dkprasad-surati/MPPT-SOLAR-CHARGE-INVERTER/v2.2/FH70PL9K7RRAJVU.webp

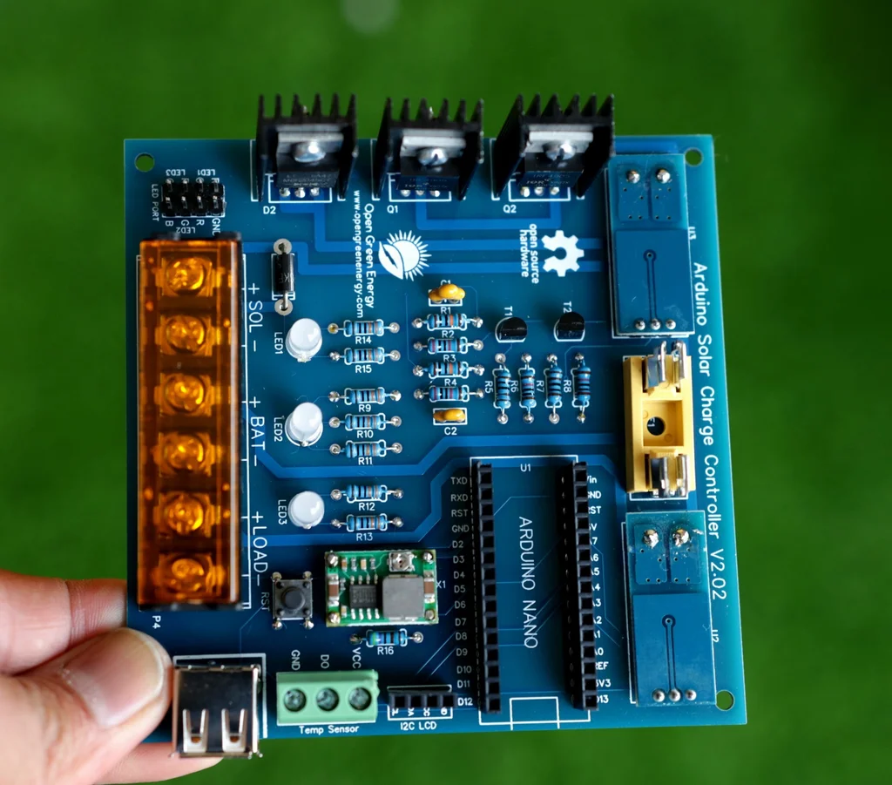
v2.2/FH70PL9K7RRAJVU.webp
