dkprasad-surati/MPPT-SOLAR-CHARGE-INVERTER/v2.2/FNMXYXHK891P6DY.webp

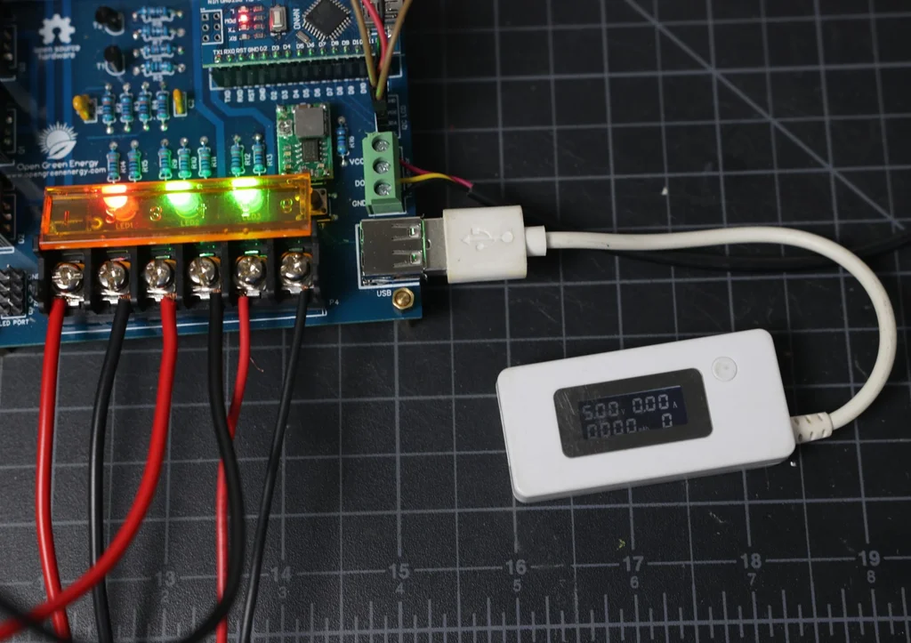
v2.2/FNMXYXHK891P6DY.webp
