dkprasad-surati/MPPT-SOLAR-CHARGE-INVERTER/README.md

# MPPT-SOLAR-CHARGE-INVERTER
SOLAR CHARGE INVERTER
