dkprasad-surati/MPPT-SOLAR-CHARGE-INVERTER/v2.2/1109151770466.png

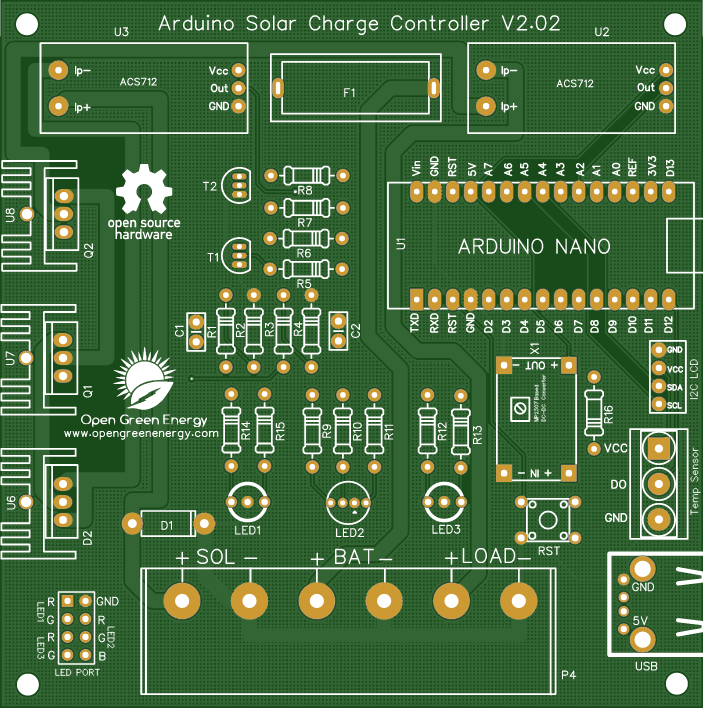
v2.2/1109151770466.png
