dkprasad-surati/MPPT-SOLAR-CHARGE-INVERTER/v2.2/F8W4K2KK891P6DU.webp

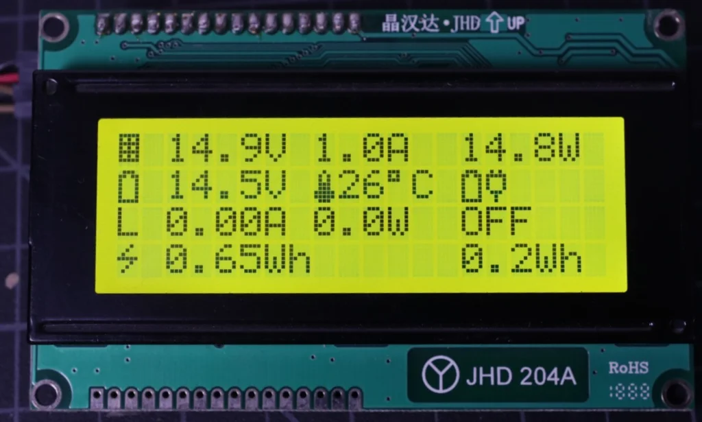
v2.2/F8W4K2KK891P6DU.webp
