dkprasad-surati/MPPT-SOLAR-CHARGE-INVERTER/v2.2/FATWU70K81UMSCC.webp

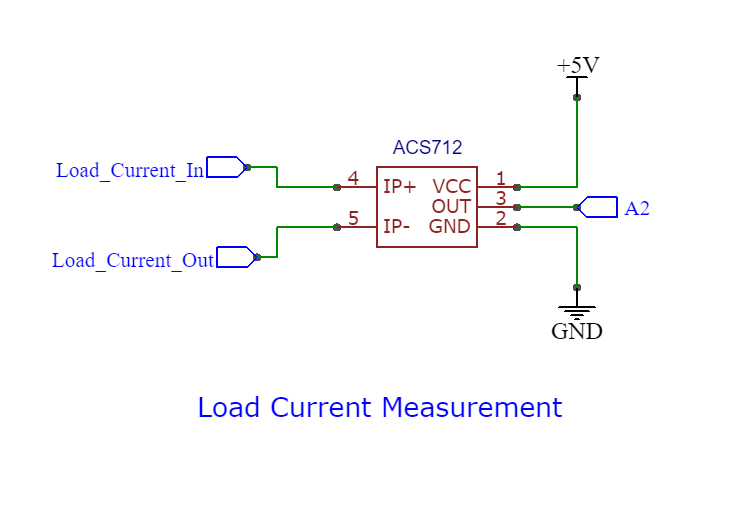
v2.2/FATWU70K81UMSCC.webp
