dkprasad-surati/MPPT-SOLAR-CHARGE-INVERTER/v2.2/FAUGJOFK7RRAL0U.webp

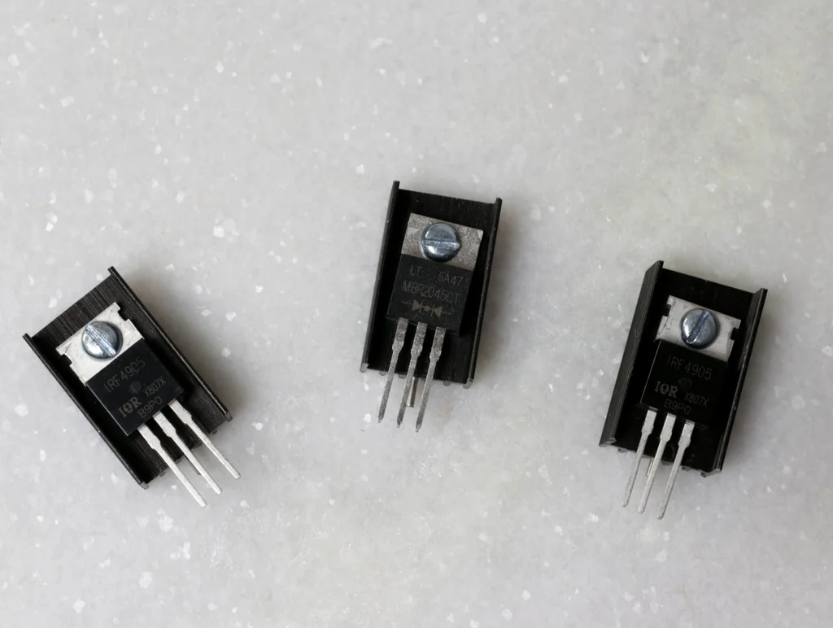
v2.2/FAUGJOFK7RRAL0U.webp
