dkprasad-surati/MPPT-SOLAR-CHARGE-INVERTER/v2.2/FCL1UGBK7RRAJVW.webp

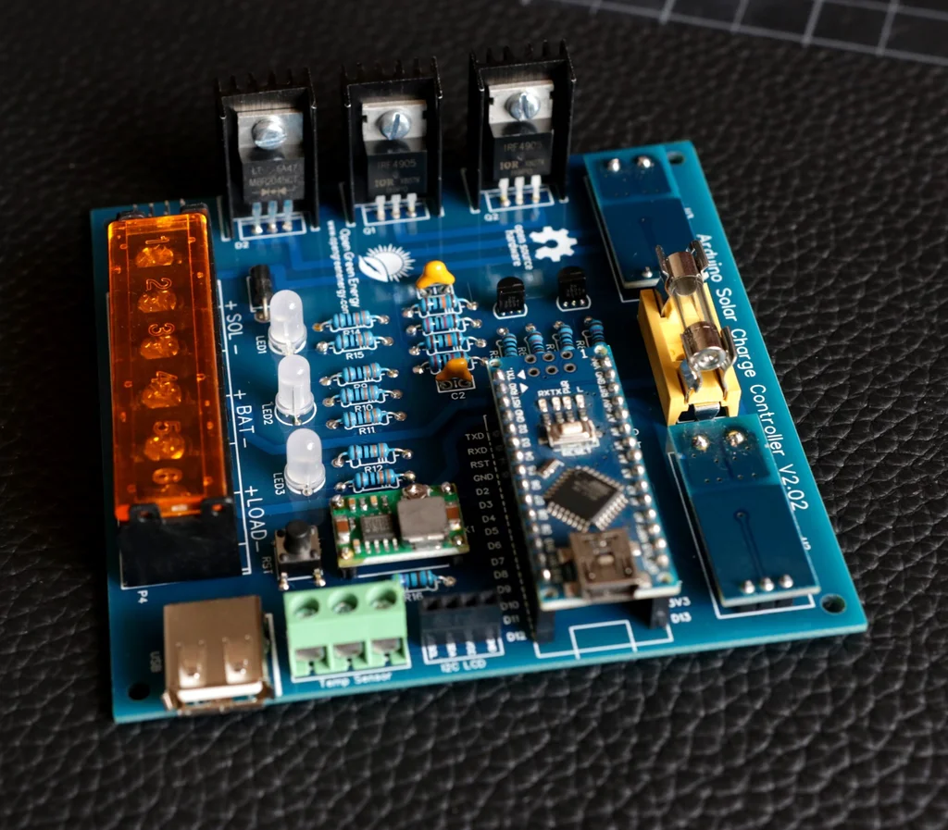
v2.2/FCL1UGBK7RRAJVW.webp
