dkprasad-surati/MPPT-SOLAR-CHARGE-INVERTER/v2.2/FDYMDO6K81UMR8P.webp

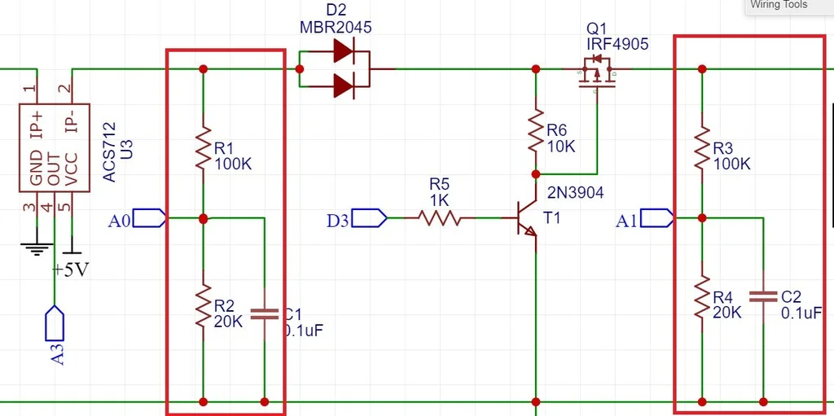
v2.2/FDYMDO6K81UMR8P.webp
