dkprasad-surati/MPPT-SOLAR-CHARGE-INVERTER/v2.2/FL9NXKZK7ZAH88T.webp

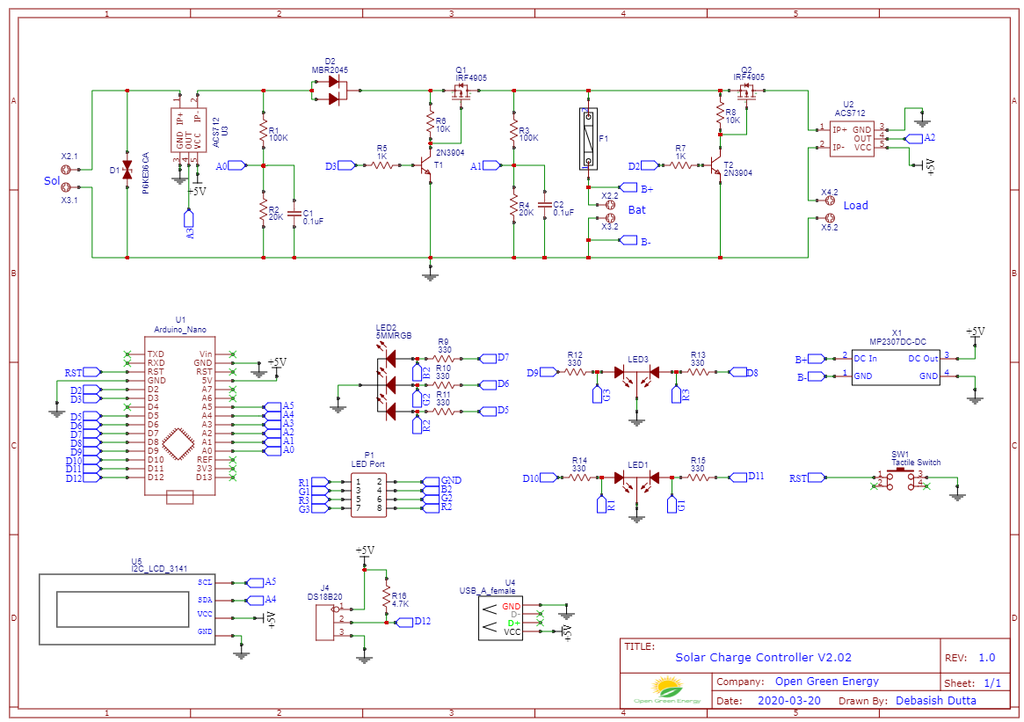
v2.2/FL9NXKZK7ZAH88T.webp
