dkprasad-surati/MPPT-SOLAR-CHARGE-INVERTER/v2.2/FLLS6NTK7VYKW1L.webp

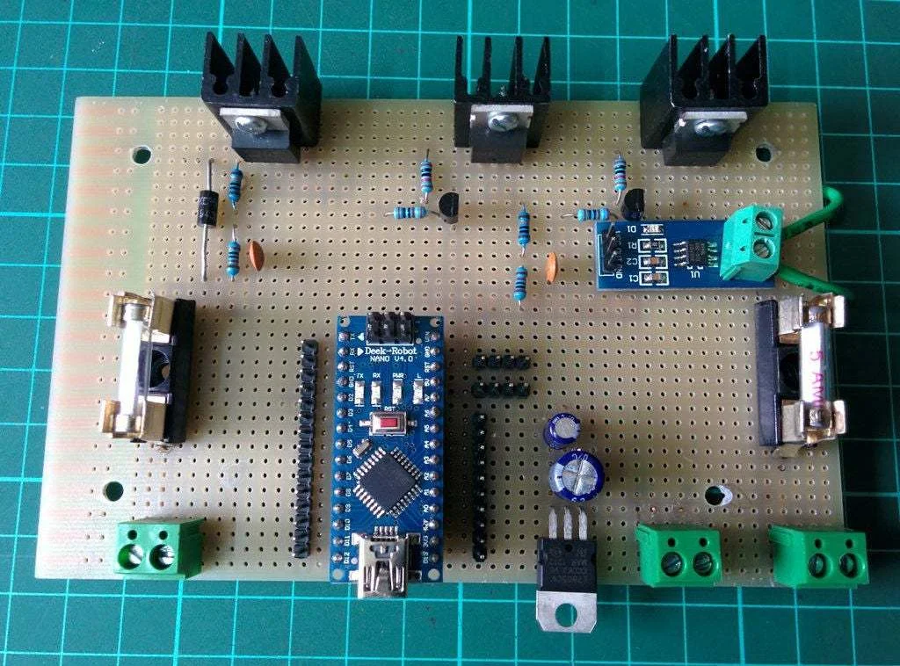
v2.2/FLLS6NTK7VYKW1L.webp
