dkprasad-surati/MPPT-SOLAR-CHARGE-INVERTER/v2.2/FLND5DZK84NFUJU.webp

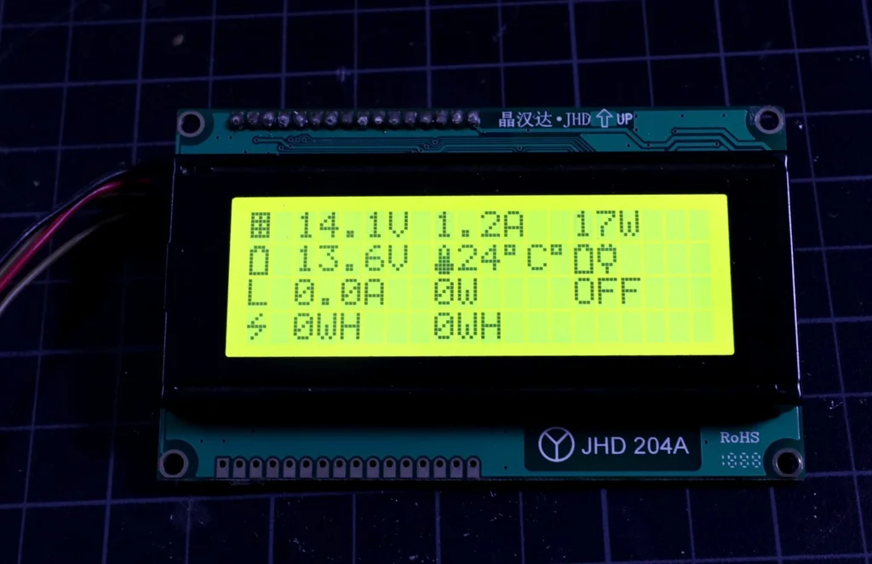
v2.2/FLND5DZK84NFUJU.webp
