dkprasad-surati/MPPT-SOLAR-CHARGE-INVERTER/v2.2/FMMB80JK7VYKW1O.webp

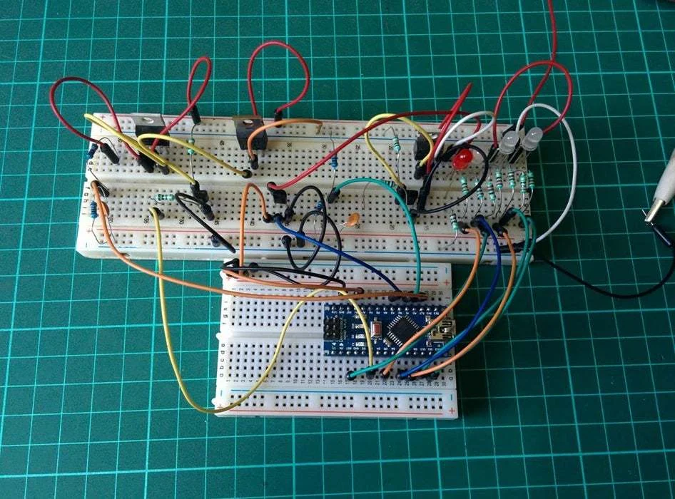
v2.2/FMMB80JK7VYKW1O.webp
