dkprasad-surati/MPPT-SOLAR-CHARGE-INVERTER/v2.2/FTX4J63K81UMX7E.webp

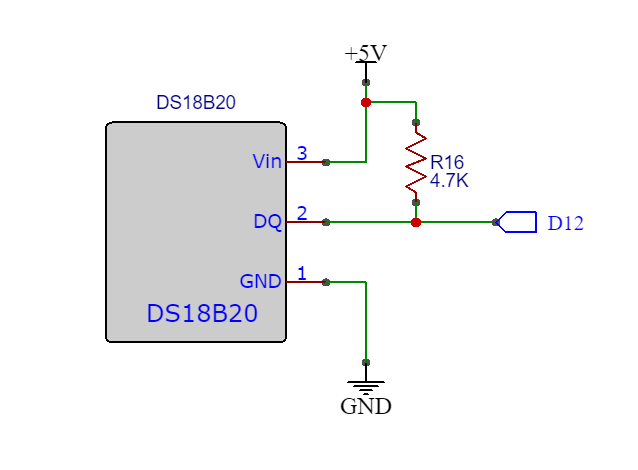
v2.2/FTX4J63K81UMX7E.webp
