dkprasad-surati/MPPT-SOLAR-CHARGE-INVERTER/v2.2/FWA54KFK7RRAJTM.webp

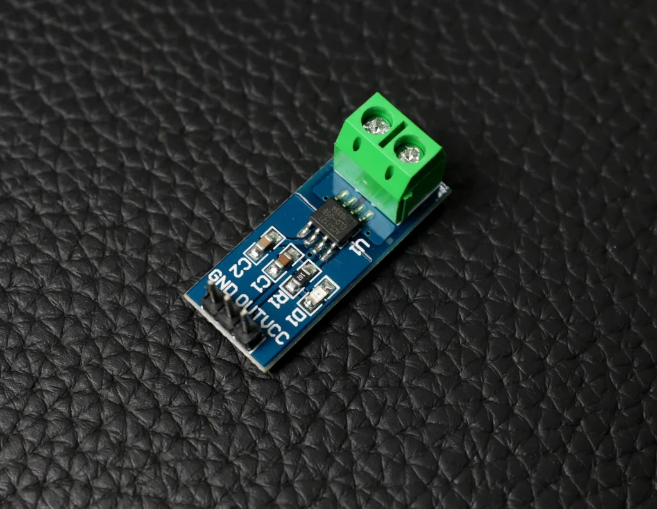
v2.2/FWA54KFK7RRAJTM.webp
