dkprasad-surati/MPPT-SOLAR-CHARGE-INVERTER/v2.2/FYMNRC1K7RRAJVV.webp

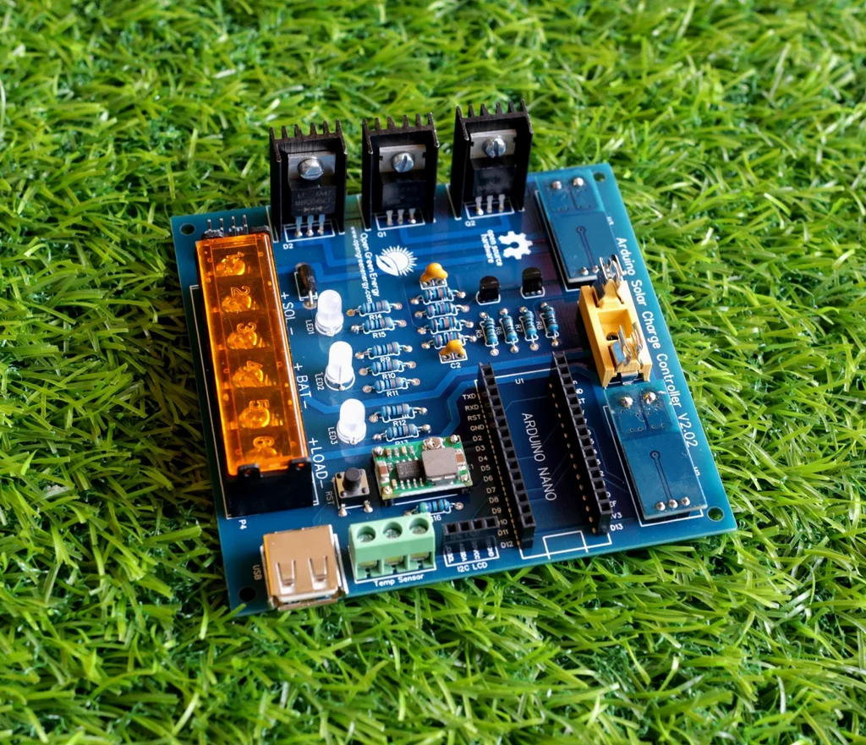
v2.2/FYMNRC1K7RRAJVV.webp
