dkprasad-surati/MPPT-SOLAR-CHARGE-INVERTER/v2.2/sdveqr.webp

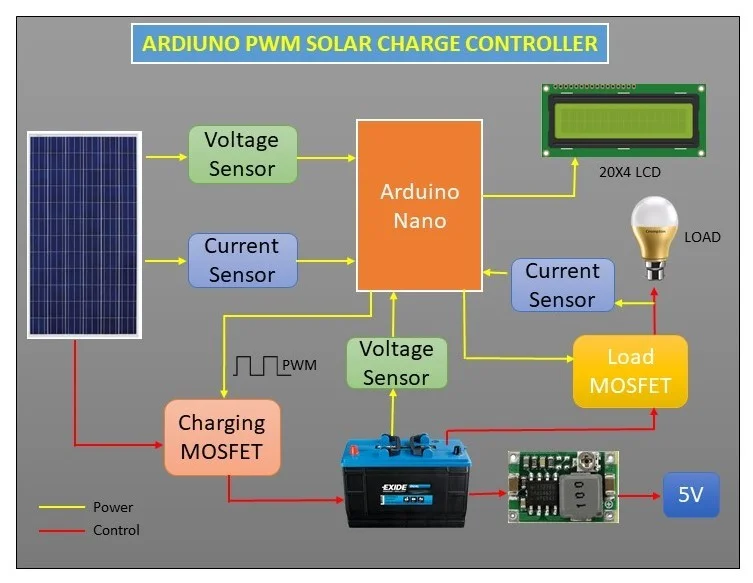
v2.2/sdveqr.webp
