dkprasad-surati/MPPT-SOLAR-CHARGE-INVERTER/v2.2/ARDUINO PWM SOLAR CHARGE CONTROLLER ( V 2.02) 25 Steps (with Pictures) - Instructables.html

Instructables instructablescircuitsProjectsContests

Enter search term

# ARDUINO PWM SOLAR CHARGE CONTROLLER ( V 2.02)

By opengreenenergy in CircuitsArduino

55,810

289

91

Featured

license

DownloadFavorite

## Introduction: ARDUINO PWM SOLAR CHARGE CONTROLLER ( V 2.02)

opengreenenergy By opengreenenergyOpen Green Energy (https://www.opengreenenergy.com/)Follow

More by the author:

DIY Mini UPS for WiFi Router V5.0

ESP8266 Weather Widget V2.0

DIY 3D-Printed Soldering Fume Extractor

About: I am a DIY hobbyist by passion and Power Engineer by profession. Most of my works are related to Solar Energy and Arduino. Apart from Electronics I love 3D printing, Woodworking and to make crafts from used … More About opengreenenergy »

(https://www.banggood.in/custlink/v3G3M9ZGNf) (https://www.banggood.in/custlink/DGGKUI8Ksj)If you are planning to install an off-grid solar system with a battery bank, you’ll need a Solar Charge Controller. It is a device that is placed between the Solar Panel and the Battery Bank to control the amount of electric energy produced by Solar panels going into the batteries. The main function is to make sure that the battery is properly charged and protected from overcharging.
As the input voltage from the solar panel rises, the charge controller regulates the charge to the batteries preventing any overcharging and disconnect the load when the battery is discharged.

You can go through my Solar projects on my website: www.opengreenenergy.com and YouTube Channel: Open Green Energy (http://www.youtube.com/c/opengreenenergy)

Types of solar charge controllers

There are currently two types of charge controllers commonly used in PV power systems :

1. Pulse Width Modulation (PWM) controller

2. Maximum Power Point Tracking (MPPT) controller

In this Instructable, I will explain to you about the PWM Solar Charge Controller. I have posted few articles on PWM charge controllers earlier too. The earlier version of my solar charge controllers are quite popular on the internet and useful for people all around the globe.

By considering the comments and questions from my earlier versions, I have modified my existing V2.0 PWM Charge Controller (https://www.instructables.com/id/ARDUINO-SOLAR-CHARGE-CONTROLLER-Version-20/) to make the new version 2.02.

The following are the changes in V2.02 w.r.t V2.0:

1. The low efficient linear voltage regulator is replaced by buck converter MP2307 for 5V power supply.

2. One additional current sensor to monitor current coming from the solar panel.

3. MOSFET-IRF9540 is replaced by IRF4905 for better performance.

4. Onboard LM35 temp-sensor is replaced by a DS18B20 probe for accurate battery temperature monitoring.

5. USB port for charging smart devices.

6. Use of single fuse instead of two

7. One additional LED to indicate Solar Power Status.

8.Implementation of 3 stages charging algorithm.

9.Implementation of PID controller in the charging algorithm

10. Made a custom PCB for the project

Specification

1.Charge controller as well as energy meter

2. Automatic Battery Voltage Selection (6V/12V)

3.PWM charging algorithm with auto charge setpoint according to the battery voltage

4.LED indication for the state of charge and load status

5. 20x4 character LCD display for displaying voltages, current, power, energy, and temperature.

6.Lightning protection

7.Reverse current flow protection

8.Short Circuit and Overload protection

9. Temperature Compensation for Charging

10. USB port for Charging Gadgets

Add TipAsk QuestionCommentDownload

## Supplies

You can order the PCB V2.02 from PCBWay (https://www.pcbway.com/project/shareproject/ARDUINO_PWM_SOLAR_CHARGE_CONTROLLER___V_2_02_.html)

(https://www.pcbway.com/project/shareproject/ARDUINO_PWM_SOLAR_CHARGE_CONTROLLER___V_2_02_.html)

1. Arduino Nano (Amazon (https://amzn.to/3a8rkF9) / Banggood (https://www.banggood.in/custlink/mmGvMI9mlo))

2.P-MOSFET - IRF4905 ( Amazon (https://amzn.to/2wpN9kR) / Banggood (https://www.banggood.in/custlink/DGD3kSZmas) )

3.Power diode -MBR2045( Amazon (https://amzn.to/2IZZf73) / Aliexpress (https://www.aliexpress.com/item/33037450545.html))

4.Buck Converter-MP2307( Amazon (https://amzn.to/2xP1IyM) / Banggood (https://www.banggood.in/custlink/GmmDzI8Dgh))

5.Temperature Sensor - DS18B20 ( Amazon (https://amzn.to/398hjX8) / Banggood (https://www.banggood.in/custlink/DDv329iKBV))

6.Current Sensor - ACS712 ( Amazon (https://amzn.to/2UpupKb) / Banggood (https://www.banggood.in/custlink/mv3vz8imgO))

7.TVS diode- P6KE36CA ( Amazon (https://amzn.to/2xaVV6x) / Aliexpress (https://www.aliexpress.com/item/32409284088.html))

8.Transistors - 2N3904 (Amazon (https://amzn.to/2J3bzTW) / Banggood (https://www.banggood.in/custlink/mm3Gk89vQH))

9.Resistors ( 100k x 2, 20k x 2,10k x 2,1k x 2, 330ohm x 7) ( Amazon (https://amzn.to/2U4fYfJ) / Banggood (https://www.banggood.in/custlink/DGGKUI8Ksj) )

10.Ceramic Capacitors (0.1uF x 2) ( Amazon (https://amzn.to/2U7knyK) / Banggood (https://www.banggood.in/custlink/v3G3M9ZGNf) )

11. 20x4 I2C LCD ( Amazon (https://amzn.to/33vVeR6) / Banggood (https://www.banggood.in/custlink/vGK3MiSRRD))

12.RGB LED ( Amazon (https://amzn.to/2wqBdiK) / Banggood (https://www.banggood.in/custlink/3K33MI8ddE))

13.Bi-Color LED ( Amazon (https://amzn.to/33zrgM0) )

15.Jumper Wires/Wires ( Amazon (https://amzn.to/390KnzL) / Banggood (https://www.banggood.in/custlink/3KDDz8IdEC))

16.Header Pins ( Amazon (https://amzn.to/2WtT2IA) / Banggood (https://www.banggood.in/custlink/GvK3zIIEyw) )

17.Heat Sinks ( Amazon (https://amzn.to/3b8Kaw3) / Aliexpress (https://www.aliexpress.com/item/32923541255.html?spm=a2g0s.9042311.0.0.27424c4d8IPTtM))

18.Fuse Holder and fuses ( Amazon (https://amzn.to/3a7hYJV) )

19.Push Button ( Amazon (https://amzn.to/2x7tdU6) / Banggood (https://www.banggood.in/custlink/mKmK29SYFb) )

22.Screw terminals 1x6 pin ( Aliexpress (https://www.aliexpress.com/item/32963802060.html?spm=a2g0s.9042311.0.0.27424c4d862aP3))

23.PCB Standoffs ( Banggood (https://www.banggood.in/custlink/KmDK2Z8hjp) )

24. USB Socket ( Amazon (https://amzn.to/2J3Is33) / Banggood (https://www.banggood.in/custlink/3vmmkiiYj0) )

Tools :

1.Soldering Iron ( Amazon (https://amzn.to/3a7vzRj) )

2. Desoldering Pump ( Amazon (https://amzn.to/392ubhp) )

2.Wire Cutter and Stripper ( Amazon (https://amzn.to/391y2vr) )

3.Screw Driver ( Amazon (https://amzn.to/2we3tp1) )

Add TipAsk QuestionCommentDownload

## Step 1: Working Principle of a PWM Charge Controller

PWM stands for Pulse Width Modulation, which stands for the method it uses to regulate charge. Its function is to pull down the voltage of the solar panel to near that of the battery to ensure that the battery is properly charged. In other words, they lock the solar panel voltage to the battery voltage by dragging the Solar panel Vmp down to the battery system voltage with no change in the current.

It uses an electronics switch ( MOSFET ) to connect and disconnect the solar panel with the battery. By switching the MOSFET at high frequency with various pulse widths, a constant voltage can be maintained. The PWM controller self-adjusts by varying the widths (lengths) and frequency of the pulses sent to the battery.

When the width is at 100%, the MOSFET is at full ON, allowing the solar panel to bulk charge the battery. When the width is at 0% the transistor is OFF open circuiting the Solar panel preventing any current from flowing to the battery when the battery is fully charged.

Add TipAsk QuestionCommentDownload

## Step 2: How the Circuit Works ?

The heart of the charge controller is an Arduino Nano board. The Arduino senses the solar panel and battery voltages by using two voltage divider circuits. According to these voltage levels, it decides how to charge the battery and control the load.

Note : In the above picture, there is typographical error in power and control signal. The redline is for power and yellow line is for control signal.

The whole schematic is divided into the following circuits:

1. Power Distribution Circuit:

The power from the battery ( B+ & B- ) is step down to 5V by the X1 ( MP2307) buck converter. The output from the buck converter is distributed to

1. Arduino Board

2. LEDs for indication

3. LCD display

4. USB port to charge gadgets.

2. Input Sensors:

The solar panel and battery voltages are sensed by using two voltage divider circuits consisting of resistors R1-R2 & R3- R4. C1 and C2 are filter capacitors to filter out the unwanted noise signals. The output from the voltage dividers is connected to Arduino analog pins A0 and A1 respectively.

The solar panel and load currents are sensed by using two ACS712 modules. The output from the current sensors is connected to Arduino analog pin A3 and A2 respectively.

The battery temperature is measured by using a DS18B20 temperature sensor. R16 (4.7K ) is a pull-up resistor. The output of the temperature sensor is connected to Arduino Digital pin D12.

3. Control Circuits:

The control circuits are basically formed by two p-MOSFETs Q1 and Q2. The MOSFET Q1 is used to send the charging pulse to the battery and MOSFET Q2 is used to drive the load. Two MOSFET driver circuits are consist of two transistors T1 and T2 with pull-up resistors R6 and R8. The base current of the transistors is controlled by resistors R5 and R7.

4. Protections Circuits:

The input overvoltage from the solar panel side is protected by using a TVS diode D1. The reverse current from the battery to the solar panel is protected by a Schottky diode D2. The overcurrent is protected by a fuse F1.

5. LED Indication:

LED1, LED2, and LED3 are used to indicate solar, battery and load status respectively. Resistors R9 to R15 are current limiting resistors.

7. LCD Display:

An I2C LCD display is used to display various parameters.

8. USB Charging:

The USB socket is hooked up to 5V output from the Buck Converter.

9. System Reset:

SW1 is a push button to reset the Arduino.

You can download the schematic in PDF format attached below.

### Attachments

- download {{ file.name }} Schematic_Arduino Solar Charge Controller V2.0_Sheet_1_20200320104815.pdf (https://content.instructables.com/ORIG/FBF/G1O4/K7ZAH87I/FBFG1O4K7ZAH87I.pdf)
  Download (https://content.instructables.com/ORIG/FBF/G1O4/K7ZAH87I/FBFG1O4K7ZAH87I.pdf)

Add TipAsk QuestionCommentDownload

## Step 3: Main Functions of Solar Charge Controller

The charge controller is designed by taking care of the following points.

1. Prevent Battery Overcharge: To limit the energy supplied to the battery by the solar panel when the battery becomes fully charged. This is implemented in charge_cycle() of my code.

2. Prevent Battery Over-discharge: To disconnect the battery from electrical loads when the battery reaches a low state of charge. This is implemented in load_control() of my code.

3. Provide Load Control Functions: To automatically connect and disconnect an electrical load at a specified time. The load will ON when the sunset and OFF when sunrise. This is implemented in load_control() of my code. 4.Monitoring Power and Energy: To monitor the load power and energy and display it.

5. Protect from abnormal Condition: To protect the circuit from the different abnormal situations like lightning, overvoltage, overcurrent, and short circuit, etc.

6.Indicating and Displaying: To indicate and display the various parameters

7.Serial Communication: To print various parameters in the serial monitor

8. USB Charging: To charge smart devices

Add TipAsk QuestionCommentDownload

## Step 4: Voltage Measurement

The voltage sensors are used to sense the voltage of solar panel and battery. It is implemented by using two voltage divider circuits. It consists of two resistors R1=100k and R2=20k for sensing the solar panel voltage and similarly R3=100k and R4=20k for battery voltage. The output from the R1and R2 is connected to Arduino analog pin A0 and output from the R3 and R4 is connected to Arduino analog pin A1.

Voltage Measurement :
Arduino’s analog inputs can be used to measure DC voltage between 0 and 5V (when using the standard 5V analog reference voltage) and this range can be increased by using a voltage divider network. The voltage divider steps down the voltage being measured within the range of the Arduino analog inputs.

For a voltage divider circuit Vout = R2/(R1+R2) x Vin

Vin = (R1+R2)/R2 x Vout

The analogRead() function reads the voltage and converts it to a number between 0 and 1023

Calibration :
We’re going to read output value with one of the analog inputs of Arduino and its analogRead() function. That function outputs a value between 0 and 1023 that is 0.00488V for each increment (As 5/1024 = 0.00488V)

Vin = Vout*(R1+R2)/R2 ; R1=100k and R2=20k

Vin= ADC count*0.00488*(120/20) Volt // Highlighted part is Scale factor

Note: This leads us to believe that a reading of 1023 corresponds to an input voltage of exactly 5.0 volts. In practical you may not get 5V always from the Arduino pin 5V. So during calibration first measure the voltage between the 5v and GND pins of Arduino by using a multimeter, and use scale factor by using the below formula:

Scale factor = measured voltage/1024

Add TipAsk QuestionCommentDownload

## Step 5: Current Measurement

For current measurement, I used a Hall Effect current sensor ACS 712 -5A variant. There are three variants of ACS712 Sensor based on the range of its current sensing. The ACS712 sensor reads the current value and converts it into a relevant voltage value, The value that links the two measurements is Sensitivity. The output sensitivity for all variant are as follows:

ACS712 Model - > Current Range- > Sensitivity

ACS712 ELC-05 - > +/- 5A - > 185 mV/A

ACS712 ELC-20 - > +/- 20A - > 100 mV/A

ACS712 ELC-30 - > +/- 30A - > 66 mV/A

In this project, I have used the 5A variant, for which sensitivity is 185mV/A and the middle sensing voltage is 2.5V when no current.

Calibration:

analog read value = analogRead(Pin);

Value = (5/1024)*analog read value // If you are not getting 5V from Arduino 5V pin then,

Current in amp = (Value – offsetVoltage) / sensitivity

But as per data sheets offset voltage is 2.5V and sensitivity is 185mV/A

Current in amp = (Value-2.5)/0.185

Add TipAsk QuestionCommentDownload

## Step 6: Temperature Measurement

Why Temperature monitoring is Required?

The battery’s chemical reactions change with temperature. As the battery gets warmer, the gassing increases. As the battery gets colder, it becomes more resistant to charging. Depending on how much the battery temperature varies, it is important to adjust the charging for temperature changes. So it is important to adjust charging to account for the temperature effects. The temperature sensor will measure the battery temperature, and the Solar Charge Controller uses this input to adjust the charge set point as required. The compensation value is - 5mv /degC/cell for lead-acid type batteries. (–30mV/ºC for 12V and 15mV/ºC for 6V battery).The negative sign of temperature compensation indicates an increase in temperature requires a reduction in charge setpoint. For more details, you may follow this article (https://batteryuniversity.com/learn/article/charging_at_high_and_low_temperatures).

Temperature Measurement by DS18B20

I have used an external DS18B20 probe for measuring the battery temperature. It uses a one-wire protocol to communicate with the microcontroller. It can be hooked up in port-J4 on the board.

To interface with the DS18B20 temperature sensor, you need to install the One Wire library (https://github.com/PaulStoffregen/OneWire) and the Dallas Temperature library (https://github.com/milesburton/Arduino-Temperature-Control-Library).

You can read this article (https://learn.adafruit.com/using-ds18b20-temperature-sensor-with-circuitpython/overview) for more details on the DS18B20 sensor.

Add TipAsk QuestionCommentDownload

## Step 7: USB Charging Circuit

The buck converter MP2307 used for power supply can deliver current up to 3A. So it has a sufficient margin for charging the USB gadgets. The USB socket VCC is connected to 5V and GND is connected to GND. You can refer to the above schematic.

Note: The USB output voltage not maintained to 5V when the load current exceeds 1A. So I would recommend limiting the USB load below 1A.

Add TipAsk QuestionCommentDownload

## Step 8: Charging Algorithm

When the controller is connected to the battery, the program will start the operation. Initially, it checks if the panel voltage is sufficient for charging the battery. If yes, then it will enter into the charge cycle. The Charge Cycle consists of 3 stages.

Stage 1 Bulk charge:

Arduino will connect the Solar Panel to the battery directly ( 99 % duty cycle). The battery voltage will increase gradually. When the battery voltage reaches 14.4V, stage 2 will begin.

In this stage, the current is almost constant.

Stage 2 Absorption charge:

In this stage, Arduino will regulate the charging current by maintaining the voltage level at 14.4 for one hour. The voltage is kept constant by adjusting the duty cycle.

Stage 3 Float charge:

The controller generates the trickle charge to maintain the voltage level at 13.5V. This stage keeps the battery to be fully charged. If the battery voltage is less than 13.2V for 10mins.

The charge cycle will be repeated.

Add TipAsk QuestionCommentDownload

## Step 9: Load Control

To automatically connect and disconnect the load by monitoring dusk/dawn and battery voltage, load control is used.

The primary purpose of load control is to disconnect the load from the battery to protect it from deep discharging. Deep discharging could damage the battery.

The DC load terminal is designed for low power DC load such as street light.

The PV panel itself is used as the light sensor.

Assuming solar panel voltage > 5V means dawn and when < 5V dusk.

ON Condition: In the evening, when the PV voltage level falls below 5V and the battery voltage is higher than the LVD setting, the controller will turn on the load and the load green led will glow.

OFF Condition: The load will cut off in the following two conditions.

1. In the morning when the PV voltage is larger than 5v,

2.When the battery voltage is lower than the LVD setting The load red led ON indicates that the load is cut off.

LVD is referred to as Low Voltage Disconnect

Add TipAsk QuestionCommentDownload

## Step 10: Power and Energy

Power: Power is the product of voltage (volt) and current (Amp)

P=VxI Unit of power is Watt or KW

Energy: Energy is the product of power (watt) and time (Hour)

E= Pxt Unit of Energy is Watt Hour or Kilowatt Hour (kWh)

To monitor the power and energy above logic is implemented in software and the parameters are displayed in a 20x4 char LCD.

Image credit: imgoat (https://imgoat.com/uploads/97da629b09/106447.jpg)

Add TipAsk QuestionCommentDownload

## Step 11: Protections

1.Reverse polarity and reverse current protection for solar panel

For reverse polarity and reverse current flow protection a Schottky diode (MBR2045) is used.

2. Overcharge & Deep discharge protection

Overcharge and deep discharge protection are implemented by the software.

3. Short circuit and overload protection

Short circuit and overload protection is realized by a fuse F1.

4.Overvoltage protection at solar panel input

Temporary overvoltages occur in power systems for a variety of reasons, but lightning causes the most severe overvoltages. This is particularly true with PV systems due to the exposed locations and system connecting cables. In this new design, I used a 600-watt bidirectional TVS diode (P6KE36CA ) to suppress the lightning and overvoltage at the PV terminals.

image credit: freeimages (https://www.freeimages.co.uk/galleries/workplace/energy/slides/electric_danger.htm)

Add TipAsk QuestionCommentDownload

## Step 12: LED Indications

1. Solar LED: LED1
A bi-color (red/green ) led is used for indicating the solar power staus i.e dusk or dawn.

Solar LED --------------------->Solar Status

GREEN -------------------------> Day

RED ---------------------------> Night

2. Battery State Of Charge (SOC) LED: LED2

One important parameter that defines the energy content of the battery is the State of Charge (SOC). This parameter indicates how much charge is available in the battery. RGB LED is used to indicate the battery state of charge. For connection refer to the above schematic.

Battery LED ------------>Battery Status

RED --------------------> Voltage is LOW

GREEN --------------------> Voltage is Healthy

BLUE --------------------> Fully Charged

2. Load LED: LED3

A bi-color (red/green) led is used for load status indication. Refer to the above schematic for connection.

Load LED --------------------->Load Status

GREEN -------------------------> Connected (ON)

RED ---------------------------> Disconnected (OFF)

Add TipAsk QuestionCommentDownload

## Step 13: LCD Display

A 20X4 char LCD is used for monitoring solar panel, battery and load parameters.

For simplicity, an I2C LCD display is chosen for this project. It needs only 4 wires to interface with the Arduino.

The connection is below:

LCD--> Arduino

VCC--> 5V ,

GND-->GND,

SDA-->A4,

SCL-->A5

Row-1: Solar panel voltage, Current and Power

Row-2: Battery Voltage, Temperature, and Charger status ( Charging / Not Charging )

Row-3: Load current, power, and load status

Row-4: Input Energy from Solar panel and Energy consumed by the load.

You have to download the library from LiquidCrystal_I2C (https://bitbucket.org/fmalpartida/new-liquidcrystal/downloads/).

Add TipAsk QuestionCommentDownload

## Step 14: Prototyping and Testing

1. Breadboard :

First, I made the circuit on a Breadboard. The main advantage of a solderless breadboard is that it’s, solderless. Thus you can easily change the design just by unplugging components and leads as you need to.

2. Perforated Board:

After making the breadboard testing, I made the circuit on a Perforated Board (https://www.instructables.com/id/ARDUINO-SOLAR-CHARGE-CONTROLLER-Version-20/). To make it follow the instruction below

i) First insert all the parts into the hole of the Perforated-Board.

ii) Solder all the component pads and trim the extra legs by a nipper.

iii) Connect the soldering pads by using wires as per the schematic.

iv) Use standoff to isolate the circuit from the ground.

The perforated board circuit is really strong and can be deployed in a project permanently. After testing the prototype, if everything works perfectly we can move to design the final PCB.

Add TipAsk QuestionCommentDownload

## Step 15: PCB Design

I have drawn the schematic by using EasyEDA (https://easyeda.com/) online software after that switched to the PCB layout.

All of the components you added in the schematic should be there, stacked on top of each other, ready to be placed and routed. Drag the components by grabbing on its pads. Then place it inside the rectangular borderline.

Arrange all the components in such a way that the board occupies minimum space. Smaller the board size, the cheaper will be the PCB manufacturing cost. It will be useful if this board has some mounting holes on it so that it can be mounted in an enclosure.

Now you have to route. Routing is the most fun part of this entire process. It’s like solving a puzzle! Using the tracking tool we need to connect all the components. You can use both the top and the bottom layer for avoiding overlap between two different tracks and making the tracks shorter.

You can use the Silk layer to add text to the board. Also, we are able to insert an image file, so I add an image of my website logo to be printed on the board. In the end, using the copper area tool, we need to create the ground area of the PCB.

Now the PCB is ready for manufacturing.

Add TipAsk QuestionCommentDownload

## Step 16: Download the Gerber Files

After making the PCB, we have to generate the files that can be sent to a PCB fabrication company that will in due course send us back some real PCB.

In EasyEDA (https://easyeda.com/) You can output the Fabrication Files(Gerber file) via Document > Generate Gerber, or by clicking the Generate Gerber button from the toolbar. The generated Gerber file is a compressed package. After decompression, you can see the following 8 files:

1. Bottom Copper: .gbl

2. Top Copper: .gtl

3. Bottom Soldering Masks: .gbs

4.Top Soldering Masks: .gts

5. Bottom Silk Screen: .gbo

6. Top Silk Screen: .gto

7. Drill: .drl

8.Outline: .outline

You can download the Gerber files from PCBWay (https://www.pcbway.com/project/shareproject/ARDUINO_PWM_SOLAR_CHARGE_CONTROLLER___V_2_02_.html)

When you place an order from PCBWay, I will get a 10% donation from PCBWay for a contribution to my work. Your little help may encourage me to do more awesome work in the future. Thank you for your cooperation.

Add TipAsk QuestionCommentDownload

## Step 17: PCB Manufacturing

Now it is time to find out a PCB manufacturer that can turn our Gerber files to a real PCB. I have sent my Gerber files to JLCPCB (https://jlcpcb.com/) for manufacturing my PCB. Their service is extremely good. I have received my PCB in India within 10 days.

The BOM for the project is attached below.

### Attachments

- download {{ file.name }} BOM for Charge Controller V2.02.pdf (https://content.instructables.com/ORIG/F7D/9K64/K8CDJTXC/F7D9K64K8CDJTXC.pdf)
  Download (https://content.instructables.com/ORIG/F7D/9K64/K8CDJTXC/F7D9K64K8CDJTXC.pdf)

Add TipAsk QuestionCommentDownload

## Step 18: Soldering the Components

After receiving the board from the PCB fab house, you have to solder the components.

For Soldering, you will need a decent Soldering Iron, Solder, Nipper, Desoldering Wicks or Pump and a multimeter.

It is good practice to solder the components according to their height. Solder the lesser height components first.

You can follow the following steps to solder the components :

1. Push the component legs through their holes, and turn the PCB on its back.

2. Hold the tip of the soldering iron to the junction of the pad and the leg of the component.

3. Feed solder into the joint so that it flows all around the lead and covers the pad. Once it has flowed all around, move the tip away.

4. Trim the extra legs by using a Nipper.

Follow the above rules for soldering all the components.

Add TipAsk QuestionCommentDownload

## Step 19: Mounting the ACS712 Current Sensor

The ACS712 current sensor I have received has a pre-soldered screw terminal for connection. To solder the module directly on the PCB board, you have to desolder the screw terminal first.

I desolder the screw terminal with the help of a desoldering pump as shown above.

Then I solder the ACS712 module upside down.

To connect the Ip+ and Ip- terminal to the PCB, I used the diode terminal legs.

Add TipAsk QuestionCommentDownload

## Step 20: Adding the Buck Converter

To solder the Buck Converter module, you have to prepare 4 straight header pins as shown above.

Solder the 4 header pins at the X1, 2 are for output and the remaining two are for inputs.

Add TipAsk QuestionCommentDownload

## Step 21: Adding the Arduino Nano

When you purchase the straight headers, they'll be too long for the Arduino Nano. You'll need to trim them down to an appropriate length. This means 15 pins each.

The best way to trim the female header pieces is to count out 15 pins, pull the 16th pin, then use a nipper to cut the gap between the 15th and 17th pin.

Now we need to install the female headers onto the PCB. Take your female headers and place them on the male headers on the Arduino Nano board.

Then solder the female header pins to the Charge Controller PCB.

Add TipAsk QuestionCommentDownload

## Step 22: Preparing the MOSFETs

Before soldering the MOSFETs Q1 Q2 and diode D1 on to the PCB, it is better to attach the heatsinks to them first. Heat sinks are used to move heat away from the device in order to maintain a lower device temperature.

Apply a layer of heatsink compound over the MOSFET metal base plate. Then place the thermally conductive pad in between the MOSFET and heat sink and tighten the screw. You can read this article (https://www.digikey.in/en/articles/techzone/2019/jan/heat-sinks-a-step-by-step-guide) about why heat sink is essential.

Finally, solder them on to the charge controller PCB.

Add TipAsk QuestionCommentDownload

## Step 23: Mounting the Standoffs

After soldering all the parts, mount the standoffs at 4 corners. I used M3 Brass Hex Standoffs.

The use of standoffs will provide sufficient clearance to the soldering joints and wires from the ground.

Add TipAsk QuestionCommentDownload

## Step 24: Software & Libraries

First, download the attached Arduino Code. Then download the following libraries and install them.

1. One Wire (https://github.com/PaulStoffregen/OneWire)

2. DallasTemperature (https://github.com/milesburton/Arduino-Temperature-Control-Library)

3. LiquidCrystal_I2C (https://bitbucket.org/fmalpartida/new-liquidcrystal/downloads/)

4. PID Library (https://github.com/br3ttb/Arduino-PID-Library/)

The entire code is broken into the small functional block for flexibility. Suppose the user is not interested to use an LCD display and happy with the led indication. Then just disable the lcd_display() from the void loop(). That's all. Similarly, according to the user requirement, he can enable and disable the various functionality.

After installing all the above libraries, upload the Arduino Code.

Note: I am now working on the software for implementing a better charging algorithm. Please keep in touch to get the latest version.

Update on 02.04.2020

Uploaded a new software with an improved charging algorithm and implementation of the PID controller in it.

### Attachments

- download {{ file.name }} Solar_Charge_Controller_V2..02_final_27.03.2020.ino (https://content.instructables.com/ORIG/F1G/DMOG/K891MRFN/F1GDMOGK891MRFN.ino)
  Download (https://content.instructables.com/ORIG/F1G/DMOG/K891MRFN/F1GDMOGK891MRFN.ino)
- download {{ file.name }} PWM-V2.02_PID_02.04.2020.rar (https://content.instructables.com/ORIG/F2E/W190/K8HKH1QL/F2EW190K8HKH1QL.rar)
  Download (https://content.instructables.com/ORIG/F2E/W190/K8HKH1QL/F2EW190K8HKH1QL.rar)

Add TipAsk QuestionCommentDownload

## Step 25: Final Testing

Connect the Charge Controller battery terminals ( BAT ) to a 12V battery. Be sure the polarity is correct. After connection, the LED and LCD will start working immediately. You will also notice the battery voltage and temperature on the 2nd row of the LCD display.

Then connect a Solar Panel to the solar terminal ( SOL ), you can see the solar voltage, current, and power on the first row of the LCD display. I have used a Lab Power supply to simulate the Solar Panel. I used my Power Meters to compare the Voltage, Current and Power values with the LCD display.

The test procedure is shown in this demo video (https://youtu.be/D6oR4-BFgQU)

In the future, I will design a 3D printed enclosure for this project. Keep in touch.

This project is an entry in the PCB Contest (https://www.instructables.com/contest/PCBdesign/), please vote for me. Your votes are a real inspiration for me to do more hard work to write more useful projects like this.

Thanks for reading my Instructable.
If you like my project, don't forget to share it.

Comments and feedback are always welcome.

Add TipAsk QuestionCommentDownload

PCB Design Challenge

Runner Up in the
PCB Design Challenge

View Contest

## Be the First to Share

Did you make this project? Share it with us!

I Made It!

## Recommendations

LED-Matrix With Web Server

LED-Matrix With Web Server by Brocki in LEDs

113 4.0K

1kW Arduino MPPT Solar Charge Controller (ESP32 + WiFi)

1kW Arduino MPPT Solar Charge Controller (ESP32 + WiFi) by ASCAS in Arduino

599 46K

DIY Fiber Optic Light Sculpture

DIY Fiber Optic Light Sculpture by andrei.erdei in LEDs

1 103 8.2K

Portable LED Lamp

Portable LED Lamp by mattwach in LEDs

20 2.8K

### Soup & Stew Speed Challenge

- Soup & Stew Speed Challenge

### Tinkercad Student Design Contest

- Tinkercad Student Design Contest

### First Time Author Contest

- First Time Author Contest

## 91 Comments

0

gauravg0205

gauravg0205

19 days ago

ReplyUpvote

I am using 40W solar panel and 12V/18Ah sealed lead acid battery. The voltage at the drain of MOSFET Q1 shows about 13V when pwm at T1 is zero. Why is that happening?
I did continuity test on MOSFET and found that it was ok.
The battery still continues to consume the full voltage available from solar panel around 14.7V even after lowering the pwm for absorption charge. What could be the reason?

Thanks

0

murfmv

murfmv

Tip 11 months ago

ReplyUpvote

The error "POSITIVE" was not declared error while compiling has caused me hours of grief
searching for and answer since the link was lost. I found the answer at www.ardumotive.com/i2clcd.html . I went to the tutorial lcd_i2c_16x2_tutorial.zip and found the answer by using the library "hd44780" library and the script statements .

NewSolar_Charge_Controller_V2..02_final_27.03.2020.ino NewSolar_Charge_Controller_V2..02_final_27.03.2020.ino (https://content.instructables.com/ORIG/F13/I9FD/KFFECZ7M/F13I9FDKFFECZ7M.ino)

1 reply

0

ilikefebris

ilikefebrismurfmv

Reply 3 months ago

ReplyUpvote

thanks for your solution for this.. I saved lots of time..

0

Bigggggggggy

Bigggggggggy

1 year ago

ReplyUpvote

Sir what a well thought out project and the presentation was excellent!! However, when I started pricing out the parts it exceeded $125 US dollar!!! A commercially made item with the same specifications and performance cost $16 US dollars. Im hoping the next version is much more cost effective as not all followers have the ability to pay such a large sum of money.

6 replies

0

bassbindevil

bassbindevilBigggggggggy

Reply 5 months ago

ReplyUpvote

The cheap charge controllers with an LCD voltage display are excellent value for money, but they don't measure how much energy is being produced or consumed, and the firmware can't be modified to support different battery voltages or chemistries.

0

tgray1

tgray1Bigggggggggy

Reply 7 months ago

ReplyUpvote

LOL. Biggggggy, some of us do this for fun and learning, not necessarily to get a cheap product.

I started working on this twelve years ago, developing a solar charger/tracker with overcharge protection, dark turn on for load, etc. using discrete components (transistors, op amps, relays and so on). It was a great accomplishment when I got the circuit designed and built, but it was so complex I never took it off the breadboard. My son looked at it and said, "I could do that with one microprocessor and a few resistors!" Hmm.

Three iterations and a dozen years later, the tracker is running on an Arduino Nano and an L298N motor driver running linear actuators made with 3d printed parts. It uses 1.5W solar panels with built in blocking diodes and overcharge protection. It works, and it charges my battery. Total cost over the years, maybe $100. Total enjoyment, priceless. Along the way I learned about microprocessors and coding.

But now it's time to add a better PV panel to the tracker, and build Debasish's charge controller, with lots of modifications (adding a PIR sensor to the load, for example). Total cost so far, maybe $100 in parts (but I'll have lots of extras for future fun). And I'll learn about PIR, buck converters, battery charging, and coding.

I wish you joy and satisfaction when building your version!

0

JerryA38

JerryA38tgray1

Reply 7 months ago

ReplyUpvote

Sir you point is well taken, but I'm saying that my 50K Chevrolet Truck would cost over 150K if I decided to build it from the parts bin..I love working on cars and trucks, but I look towards value so I have MORE MONEY to spend on other projects!!!!

0

opengreenenergy

opengreenenergyBigggggggggy

Reply 1 year ago

ReplyUpvote

Dear Sir,
The amazon links are for reference, I prepared a BOM with prices of each component in Aliexpress. The project cost is below $15. I am attaching the BOM with links in step-17: PCB manufacturing.
Hope it will be helpful for you now.

0

Bigggggggggy

Bigggggggggyopengreenenergy

Reply 1 year ago

ReplyUpvote

Thank you sir for the quick response!! I expect that projects with this much detail are going to cost above most commercial products, but not 4 to 5 times as much...Super project and super response...and thank you for the BOM...

0

BarryD43

BarryD43Bigggggggggy

Reply 1 year ago

ReplyUpvote

thank you for that, I immediately went to the pcbway site and there is no listed price, so that automatically raised the hairs on the back of my neck as I am on a disability pension and therefore always on the lookout for diy stuff that is cheaper than the commercial one. Not the other way around

0

amelchahmi

amelchahmi

5 months ago

ReplyUpvote

Great work, can i use this for a 9v battery ? Should i just change the voltage divider or there's more changes ?

0

ApieGoku

ApieGoku

6 months ago

ReplyUpvote

Hi, I want to add WiFi to this control. I already bought 5 board from PCBWay. And does

(https://arduino.stackexchange.com/questions/17590/arduino-nano-v3-0-with-esp8266)

(https://arduino.stackexchange.com/questions/17590/arduino-nano-v3-0-with-esp8266)Arduino Nano v3.0 with ESP8266 (https://arduino.stackexchange.com/questions/17590/arduino-nano-v3-0-with-esp8266) also work?

Please, help needed. Kind regards

0

tgray1

tgray1

11 months ago

ReplyUpvote

Looking at the code, I note that the average room temperature is taken as 25C. I need this project to work outside; where I live (Alberta, Canada) temperatures can range from a very rare 30C to an all too common -35C, with the average annual temperature being 8.5C. What a difference between here and India!
Generally, a trickle charge will keep a battery from freezing up, so I expect this will work here in the winter.

2 replies

0

tgray1

tgray1tgray1

Reply 7 months ago

ReplyUpvote

I have since learned that the 25C figure is not exactly "standard room temperature" as given in the code, but is considered the "standard charging temperature" for lead-acid batteries.
https://batteryuniversity.com/learn/article/charging_at_high_and_low_temperatures

https://batteryuniversity.com/index.php/learn/article/charging_the_lead_acid_battery

0

murfmv

murfmvtgray1

Reply 11 months ago

ReplyUpvote

This temperature protection, I believe, is protecting the battery from overcharging and heating up. That isn’t a concern in your area.

0

mzelectronic

mzelectronic

1 year ago

ReplyUpvote

Hello.
I created a V2.0 PWM Charge Controller. Now you have modified that and made a new V2.02. The difference is in MOSFET. Can I use an existing IRF9540 or do I need to put an IRF4905? What's the difference?
Also, I changed the resistors on the voltage divider and some values in the program itself, since I use a 24v system.
As for the program, I have two questions:
1.In the setup section:
sensors.begin ();
I'm getting an error. If I remove that line, everything is fine. I do not understand this function.
2. Why is this marked as a comment in STAGE-2 (ABSORPTION CHARGING) ?:
/ * error = (bat_volt - bulk_charge_sp); // duty cycle reduced when the battery voltage approaches the charge set point and vice versa
if (abs (error) <0.3) {
pwm_duty = pwm_duty - error * 25.5;
}
else {
pwm_duty = pwm_duty - error * 255;
}
* /

Thanks in advance.
Marko, Varazdin, Croatia.

3 replies

0

opengreenenergy

opengreenenergymzelectronic

Reply 1 year ago

ReplyUpvote

Hi Sorry for the late reply.
sensors.begin (); is used for temperature sensor DS18B20.
The section is commented because I have used PID controller algorithm instead of my earlier code.

0

tgray1

tgray1opengreenenergy

Reply 7 months ago

ReplyUpvote

Love this project and in the process of building V2.0.2 The code I am using is dated 24/03/2020.

Where is the PID algorithm? I've checked the PID library and I don't see any of it in your code. I've done PID tuning on my 3d printers and I was looking for Ki, Kp, and Kd in the code, kind of like at https://www.teachmemicro.com/arduino-pid-control-tutorial/. Perhaps I do not have the latest version?

Temperature is handled in these four lines:
OneWire oneWire(ONE_WIRE_BUS); // set up a OneWire to communicate with OneWire devices
DallasTemperature sensors(&oneWire); // pass the above to the Dallas Temp sensor
sensors.requestTemperatures(); // get temperature reading
temperature=sensors.getTempCByIndex(0); // poll the first IC on the wire and store in the variable "temperature"

Thanks in advance for addressing this.

0

mzelectronic

mzelectronicopengreenenergy

Reply 1 year ago

ReplyUpvote

Can I use an existing IRF9540 or do I need to put an IRF4905? What's the difference?

Thank You!

0

NoOne38

NoOne38

Question 9 months ago

AnswerUpvote

Hello ,
very nice project that I am trying to achieve but I am
penalized by the instability at low load of the ACS712. Would you have a
solution please? (pardon my English)

More CommentsPost Comment

Categories

- Circuits
- Workshop
- Craft
- Cooking
- Living
- Outside
- Teachers

About Us

- Who We Are
- Why Publish?

Resources

- Sitemap
- Help
- Contact

Find Us

- (https://www.instagram.com/instructables/)
- (https://www.pinterest.com/instructables)
- (https://www.facebook.com/instructables)
- (https://www.twitter.com/instructables)

© 2021 Autodesk, Inc.

- Terms of Service (http://usa.autodesk.com/adsk/servlet/item?siteID=123112&id=21959721)|
- Privacy Statement (http://usa.autodesk.com/adsk/servlet/item?siteID=123112&id=21292079)|
- Privacy settings|
- Legal Notices & Trademarks (http://usa.autodesk.com/legal-notices-trademarks/)

Autodesk (http://www.autodesk.com)
