dkprasad-surati/MPPT-SOLAR-CHARGE-INVERTER/v2/ARDUINO SOLAR CHARGE CONTROLLER ( Version 2.0) 26 Steps (with Pictures) - Instructables.html

Instructables instructablescircuitsProjectsContests

Enter search term

# ARDUINO SOLAR CHARGE CONTROLLER ( Version 2.0)

By opengreenenergy in CircuitsArduino

751,502

2,108

825

Featured

license

DownloadFavorite

## Introduction: ARDUINO SOLAR CHARGE CONTROLLER ( Version 2.0)

opengreenenergy By opengreenenergyOpen Green Energy (https://www.opengreenenergy.com/)Follow

More by the author:

DIY Mini UPS for WiFi Router V5.0

ESP8266 Weather Widget V2.0

DIY 3D-Printed Soldering Fume Extractor

About: I am a DIY hobbyist by passion and Power Engineer by profession. Most of my works are related to Solar Energy and Arduino. Apart from Electronics I love 3D printing, Woodworking and to make crafts from used … More About opengreenenergy »

[ Play Video ] (https://youtu.be/joWzuFZGZcE)

One year ago, I began building my own solar system to provide power for my village house. Initially, I made a LM317 based charge controller and an Energy meter for monitoring the system. Finally, I made a PWM charge controller. In April-2014 I posted my PWM solar charge controller designs on the web, it became very popular. Lots of people all over the world have built their own. So many students have made it for their college project by taking help from me. I got several emails every day from people with questions regarding hardware and software modification for different rated solar panel and battery. A very large percentage of the emails are regarding the modification of the charge controller for a 12Volt solar system.

You can find all of my projects on https://www.opengreenenergy.com/

Update on 25.03.2020:

I have upgraded this project and made a custom PCB for it. You can see the full project in the below link:

ARDUINO PWM SOLAR CHARGE CONTROLLER ( V 2.02) (https://www.instructables.com/id/ARDUINO-PWM-SOLAR-CHARGE-CONTROLLER-V-202/)

To solve this problem I made this new version charge controller so that anyone can use it without changing the hardware and software. I combine both the energy meter and charge controller in this design.

Specification of version-2 charge controller :

1.Charge controller as well as energy meter

2. Automatic Battery Voltage Selection (6V/12V)

3.PWM charging algorithm with auto charge setpoint according to the battery voltage

4.LED indication for the state of charge and load status

5. 20x4 character LCD display for displaying voltages, current, power, energy, and temperature.

6.Lightning protection

7.Reverse current flow protection

8.Short Circuit and Overload protection

9. Temperature Compensation for Charging

Electrical specifications :

1.Rated Voltage= 6v /12V

2.Maximum current = 10A

3.Maximum load current =10A

4.Open Circuit Voltage = 8-11V for 6V system /15 -25V for 12V system

Add TipAsk QuestionCommentDownload

## Step 1: Parts and Tools Required :

Parts:

1.Arduino Nano (Amazon (http://goo.gl/YeeYce) / Banggood (https://www.banggood.in/custlink/GvGvWWRppt))

2.P-MOSFET ( Amazon (http://goo.gl/OR0Ttu) / IRF 9540 (http://www.ebay.com/itm/5-x-IRF9540-P-Channel-Power-MOSFET-23A-100V-TO-220-IR-/201161974643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) x2 )

3.Power diode ( Amazon (http://goo.gl/vuKhTm) / MBR 2045 (http://www.ebay.com/itm/2pcs-MBRF2045CT-MBR2045-DIODE-SCHOTTKY-45V-20A-TO-220-/181383569951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) for 10A and IN5402 for 2A)

4.Buck Converter ( Amazon (http://goo.gl/yzkorW) / Banggood (https://www.banggood.in/custlink/3K3DCCEpJf))

5.Temperature Sensor( Amazon (http://goo.gl/xHmZ5A) / Banggood (https://www.banggood.in/custlink/3vDDWChpFR))

6.Current Sensor ( Amazon (http://goo.gl/xHmZ5A)/ Banggood (https://www.banggood.in/custlink/GKmGJJycVP))

7.TVS diode ( Amazon (http://goo.gl/VFHgWD) / P6KE36CA (http://www.ebay.com/itm/P6KE36-TVS-DO-15-P6KE36CA-E3-54-/231357840535))

8.Transistors ( 2N3904 (http://www.ebay.com/itm/10-pcs-2N3904-TRANSISTOR-NPN-40V-200mA-TO-92-/180847922895?pt=LH_DefaultDomain_0) or Banggood (https://www.banggood.in/custlink/DKvKJWhWFB) )

9.Resistors ( 100k x 2, 20k x 2,10k x 2,1k x 2, 330ohm x 5) : Banggood (https://www.banggood.in/custlink/mvKDJphJPu)

10.Ceramic Capacitors (0.1uF x 2) : Banggood (https://www.banggood.in/custlink/mKmDpCYriV)

11.Electrolytic Capacitors ( 100uF and 10uF): Banggood (https://www.banggood.in/custlink/K3G3rcyciR)

12. 20x4 I2C LCD ( Amazon (http://goo.gl/NUSqdE) / Banggood (https://www.banggood.in/custlink/KvvGWWdr9o))

13.RGB LED ( Amazon (http://goo.gl/Fw1U82) / Banggood (https://www.banggood.in/custlink/GDmmccdC9Q))

14.Bi Color LED ( Amazon (http://goo.gl/EHKC5Y) )

15.Jumper Wires/Wires(Banggood (https://www.banggood.in/custlink/DmG3rWhJaj))

16.Header Pins ( Amazon (https://amzn.to/2I5fHEA) / Banggood (https://www.banggood.in/custlink/D3DGrJdpjb) )

17.Heat Sink ( Amazon (http://goo.gl/L4rnic) / Banggood (https://www.banggood.in/custlink/D3K3CJYraq))

18.Fuse Holder and fuses ( Amazon (http://goo.gl/nDureh) / eBay (http://www.ebay.com/itm/5pcs-Panel-Mount-PCB-Fuse-Holder-Case-w-Cover-5x20mm-/181436161574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))

19.Push Button ( Amazon (http://goo.gl/QPXwuM)/ Banggood (https://www.banggood.in/custlink/vKKDCWYrlf) )

20.Perforated Board (Amazon (http://goo.gl/WdRs2x) / Banggood (https://www.banggood.in/custlink/3DDGCWYpBd))

21.Project Enclosure ( Banggood (https://www.banggood.in/custlink/KDDDcrhJgr) )

22.Screw terminals ( 3x 2pin (http://www.ebay.com/itm/10pcs-x-2-Pin-Screw-Terminal-Block-Connector-5mm-Pitch-G-/400633791779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) and 1x6 pin (http://www.ebay.com/itm/6-Pin-Terminal-Strip-8-32-Screw-/200984426384?pt=LH_DefaultDomain_0)) : Banggood (https://www.banggood.in/custlink/mv3GcJYr05)

23.Nuts/Screws/Bolts ( Banggood (https://www.banggood.in/custlink/33vvrpYJ4B) )

24.Plastic Base

Tools :

1.Soldering Iron ( Amazon (http://goo.gl/ZuP1Km) )

2.Wire Cutter and Stripper ( Amazon (http://goo.gl/JmBxUF) )

3.Screw Driver ( Amazon (http://goo.gl/1y7cPj) )

4.Cordless Drill ( Amazon (http://goo.gl/ZWjBXQ))

5.Dremel ( Amazon (http://goo.gl/ZAgCCZ) )

6.Glue Gun ( Amazon (http://goo.gl/Tq50x2) )

7.Hobby Knife ( Amazon (http://goo.gl/SSkTXG))

Add TipAsk QuestionCommentDownload

## Step 2: How the Charge Controller Works :

The heart of the charge controller is Arduino nano board. The Arduino MCU senses the solar panel and battery voltages. According to these voltages, it decides how to charge the battery and control the load.

The amount of charging current is determined by the difference between battery voltage and charge setpoint voltages. The controller uses two stages charging algorithm. According to the charging algorithm, it gives a fixed frequency PWM signal to the solar panel side p-MOSFET. The frequency of the PWM signal is 490.20Hz(default frequency for pin-3). The duty cycle 0-100% is adjusted by the error signal.

The controller gives a HIGH or LOW command to the load side p-MOSFET according to the dusk/dawn and battery voltage.

The full schematic is attached below.

You can read my latest article (https://www.opengreenenergy.com/post/selecting-solar-charge-controller) on selecting the right charge controller for your Solar PV System

### Attachments

- download {{ file.name }} charge controller version -2.pdf (https://content.instructables.com/ORIG/F2S/BFVU/I8SLPCIY/F2SBFVUI8SLPCIY.pdf)
  Download (https://content.instructables.com/ORIG/F2S/BFVU/I8SLPCIY/F2SBFVUI8SLPCIY.pdf)

Add TipAsk QuestionCommentDownload

## Step 3: Main Functions of Solar Charge Controller:

The charge controller is designed by taking care of the following points.

1. Prevent Battery Overcharge: To limit the energy supplied to the battery by the solar panel when the battery becomes fully charged. This is implemented in charge_cycle() of my code.

2. Prevent Battery Over discharge: To disconnect the battery from electrical loads when the battery reaches a low state of charge. This is implemented in load_control() of my code.

3. Provide Load Control Functions: To automatically connect and disconnect an electrical load at a specified time. The load will ON when the sunset and OFF when sunrise. This is implemented in load_control() of my code.

4.Monitoring Power and Energy: To monitor the load power and energy and display it.

5. Protect from abnormal Condition: To protect the circuit from the different abnormal situation like lightning, overvoltage, overcurrent and short circuit, etc.

6.Indicating and Displaying: To indicate and display the various parameters

7.Serial Communication: To print various parameters in the serial monitor

Add TipAsk QuestionCommentDownload

## Step 4: Sensing Voltages,Current and Temperature :

1.Voltage Sensor:

The voltage sensors are used to sense the voltage of solar panel and battery. It is implemented by using two voltage divider circuits. It consists of two resistors R1=100k and R2=20k for sensing the solar panel voltage and similarly R3=100k and R4=20k for battery voltage. The output from the R1and R2 is connected to Arduino analog pin A0 and output from the R3 and R4 is connected to Arduino analog pin A1.

2.Current Sensor :

The current sensor is used for measuring the load current. later this current is used to calculate the load power and energy. I used a hall effect current sensor (ACS712-20A)

3.Temperature Sensor :

The temperature sensor is used to sense room temperature. I used the LM35 temperature sensor which is rated for −55°C to +150°C Range.

Why Temperature monitoring is Required?

The battery’s chemical reactions change with temperature. As the battery gets warmer, the gassing increases. As the battery gets colder, it becomes more resistant to charging. Depending on how much the battery temperature varies, it is important to adjust the charging for temperature changes. So it is important to adjust charging to account for the temperature effects. The temperature sensor will measure the battery temperature, and the Solar Charge Controller uses this input to adjust the charge set point as required. The compensation value is - 5mv /degC/cell for lead-acid type batteries. (–30mV/ºC for 12V and 15mV/ºC for 6V battery).The negative sign of temperature compensation indicates an increase in temperature requires a reduction in charge setpoint.

For more details on Understanding and Optimizing Battery Temperature Compensation (http://solarprofessional.com/articles/design-installation/understanding-and-optimizing-battery-temperature-compensation)

Add TipAsk QuestionCommentDownload

## Step 5: Sensors Callibration

Voltage Sensors :

5V = ADC count 1024

1 ADC count = (5/1024)Volt= 0.0048828Volt

Vout=Vin*R2/(R1+R2)

Vin = Vout*(R1+R2)/R2 R1=100 and R2=20

Vin= ADC count*0.00488*(120/20) Volt

Current Sensor:

As per seller information for ACS 712 current sensor

Sensitivity is =100mV / A =0.100V/A

No test current through the output voltage is VCC / 2= 2.5

ADC count= 1024/5*Vin and Vin=2.5+0.100*I (where I=current)

ADC count= 204.8(2.5+0.1*I) =512+20.48*I

=> 20.48*I = (ADC count-512)

=> I =(ADC count/20.48)- 512/20.48

Current (I) =0.04882*ADC -25

More details on ACS712 (http://www.arduinothaishop.com/productdetail.html?id=6827)

Temperature Sensor :

As per data sheet of LM35 (http://www.ti.com.cn/cn/lit/ds/symlink/lm35.pdf)

Sensitivity=10 mV/°C

Temp in deg C =(5/1024)*ADC count*100

Note : The sensors are calibrated by assuming the arduino Vcc= 5V reference.But in practical it is not 5V always.So there may be chance of getting wrong value from the actual value.It can be solved by following way.

Measure the voltage between Arduino 5V and GND by a multimeter. Use this voltage instead of 5V for Vcc in your code. Hit and try to edit this value until it matches the actual value.

Example: I got 4.47V instead of 5V.So the change should be 4.47/1024=0.0043652 instead of 0.0048828.

Add TipAsk QuestionCommentDownload

## Step 6: Charging Algorithm

1.Bulk: At this mode, a preset maximum constant amount of current (amps) is fed into the battery as no PWM is present. As the battery is being charged up, the voltage of the battery increases gradually

2. Absorption: When the battery reaches the bulk charge set voltage, the PWM begins to hold the voltage constant. This is to avoid over-heating and over-gassing the battery. The current will taper down to safe levels as the battery becomes more fully charged.
3. Float: When the battery is fully recharged, the charging voltage is reduced to prevent further heating or gassing of the battery

This is the ideal charging procedure.

The present charge cycle block of code is not implemented 3 stages charging. I use an easier logic in 2 stages. It works well.

I am trying the following logic for implementing the 3 stages charging.

Future Planning for Charging Cycle :

The bulk charge begins when the solar panel voltage is larger than the battery voltage. When the battery voltage reaches 14.4V, absorption charge will be entered. The charging current will be regulated by the PWM signal to maintain the battery voltage at 14.4V for one hour. Float charge will then enter after one hour. The float stage generates a trickle charge to keep the battery voltage at 13.6V. When the battery voltage falls below 13.6V for 10mins, the charging cycle will be repeated.

I request community members to help me for writing the piece of code to implement the above logic.

Add TipAsk QuestionCommentDownload

## Step 7: Load Control

To automatically connect and disconnect the load by monitoring dusk/dawn and battery voltage, load control is used.

The primary purpose of load control is to disconnect the load from the battery to protect it from deep discharging. Deep discharging could damage the battery.

The DC load terminal is designed for low power DC load such as street light.

The PV panel itself is used as the light sensor.

Assuming solar panel voltage >5V means dawn and when < 5V dusk.

ON Condition:

In the evening, when the PV voltage level falls below 5V and the battery voltage is higher than LVD setting, the controller will turn on the load and the load green led will glow.

OFF Condition:

The load will cut off in the following two conditions.

1. In the morning when the PV voltage is larger than 5v,

2.When the battery voltage is lower than the LVD setting

The load red led ON indicates that load is cut off.

LVD is referred to as Low Voltage Disconnect

Add TipAsk QuestionCommentDownload

## Step 8: Power and Energy

Power :

Power is the product of voltage (volt) and current (Amp)

P=VxI

Unit of power is Watt or KW

Energy:

Energy is the product of power (watt) and time (Hour)

E= Pxt

Unit of Energy is Watt Hour or Kilowatt Hour (kWh)

To monitor the load power and energy above logic is implemented in software and the parameters are displayed in a 20x4 char LCD.

Add TipAsk QuestionCommentDownload

## Step 9: Protection

1.Reverse polarity protection for solar panel

2. Overcharge protection

3. Deep discharge protection

4. Short circuit and Overload protection

5.Reverse current protection at night

6.Overvoltage protection at solar panel input

For reverse polarity and reverse current flow protection I used a power diode (MBR2045). Power diode is used to handle a large amount of current. In my earlier design, I used a normal diode(IN4007).

Overcharge and Deep discharge protection are implemented by the software.

Overcurrent and overload protection is implemented by using two fuses ( one at the solar panel side and other at load side).

Temporary overvoltages occur in power systems for a variety of reasons, but lightning causes the most severe overvoltages. This is particularly true with PV systems due to the exposed locations and system connecting cables. In this new design, I used a 600-watt bidirectional TVS diode (P6KE36CA ) to suppress the lightning and overvoltage at the PV terminals. In my earlier design, I used a Zener diode. You can also use a similar TVS diode on the load side.

For selection guide of TVS diode click here (http://www.microsemi.com/document-portal/doc_view/14650-how-to-select-a-transient-voltage-suppressor)

For choosing a right part no for TVS diode click here (http://www.littelfuse.com/~/media/electronics/datasheets/tvs_diodes/littelfuse_tvs_diode_p6ke_datasheet.pdf.pdf)

Add TipAsk QuestionCommentDownload

## Step 10: LED Indication

Battery State Of Charge (SOC) LED:

One important parameter that defines the energy content of the battery is the State of Charge (SOC). This parameter indicates how much charge is available in the battery

An RGB LED is used to indicate the battery state of charge. For connection refer to the above schematic

Battery LED ------------>Battery Status

RED --------------------> Voltage is LOW

GREEN --------------------> Voltage is Healthy

BLUE --------------------> Fully Charged

Load LED :

A bi-color (red/green) led is used for load status indication. Refer the above schematic for connection.

Load LED --------------------->Load Status

GREEN -------------------------> Connected (ON)

RED ---------------------------> Disconnected (OFF)

I include a third led for indicating the solar panel status.

Add TipAsk QuestionCommentDownload

## Step 11: LCD Display

To display the voltage, current, power, energy and temperature a 20x4 I2C LCD is used. If you do not want to display the parameter then disable the lcd_display() from the void loop() function. After disable you have indication led to monitoring the battery and load status.

You can refer this instructable for I2C LCD (https://www.instructables.com/id/I2C-LCD-Controller-the-easy-way/)

Download the LiquidCrystal _I2C library from here (https://bitbucket.org/fmalpartida/new-liquidcrystal/downloads/)

Note: In code, you have to change the I2C module address. You can use the address scanner (https://www.instructables.com/id/I2C-LCD-Controller-the-easy-way/)code given in the link.

Add TipAsk QuestionCommentDownload

## Step 12: Bread Board Testing

It is always a good idea to test your circuit on a breadboard before soldering it together.

After connecting everything upload the code. The code is attached below.

The entire software is broken into the small functional block for flexibility. Suppose the user is not interested to use an LCD display and happy with the led indication. Then just disable the lcd_display() from the void loop(). That's all.

Similarly, according to the user requirement, he can enable and disable the various functionality.

Download the code from my GitHub Account

ARDUINO-SOLAR-CHARGE-CONTROLLER-V-2 (https://github.com/deba168/ARDUINO-SOLAR-CHARGE-CONTROLLER-V-2)

### Attachments

- download {{ file.name }} solar charge controller code.txt (https://content.instructables.com/ORIG/FXU/IHN4/I283QTG2/FXUIHN4I283QTG2.txt)
  Download (https://content.instructables.com/ORIG/FXU/IHN4/I283QTG2/FXUIHN4I283QTG2.txt)

Add TipAsk QuestionCommentDownload

## Step 13: Power Supply and Terminals :

Terminals :

Add 3 screw terminals for solar input, battery and load terminal connections. Then solder it. I used the middle screw terminal for battery connection, left to it is for solar panel and the right one is for the load.

Power Supply:

In my previous version, the power supply for Arduino was provided by a 9V battery. In this version, the power is taken from the charging battery itself. The battery voltage is step down to 5V by a voltage regulator(LM7805).

Solder LM7805 voltage regulator near to the battery terminal. Then solder the electrolytic capacitors as per schematic. At this stage connect the battery to the screw terminal and check the voltage between pin 2 and 3 of LM7805. It should be near to 5V.

When I used a 6V battery the LM7805 works perfectly. But for the 12V battery, it heated up after some time. So I request to use a heat sink for it.

Efficient Power supply :

After a few testing, I found that the voltage regulator LM7805 is not the best way to power the Arduino as it wastes lots of power in the form of heat. So I decide to change it by a DC-DC buck converter which is highly efficient. If you plan to make this controller, I advise using a buck converter rather than LM7805 voltage regulator.

Buck Converter Connection:

IN+ -------> BAT+

IN- --------> BAT-

OUT+ -----> 5V

OUT- -----> GND

Refer the above pictures.

You can buy it from eBay (http://www.ebay.com/itm/310683416079?_trksid=p2060778.m2749.l2649&ssPageName=STRK%3AMEBIDX%3AIT)

Add TipAsk QuestionCommentDownload

## Step 14: Mount the Arduino :

Cut 2 female header strips of 15 pins each. Place the nano board for reference. Insert the two headers according to the nano pin. Check it whether the nano board is perfect to fit into it. Then solder it back side.

Insert two rows of the male header on both sides of the Nano board for external connections. Then join the solder points between Arduino pin and header pins. See the above picture.

Initially, I forgot to add Vcc and GND headers. At this stage, you can put headers with 4 to 5 pins for Vcc and GND.

As you can see I connected the voltage regulator 5V and GND to the nano 5V and GND by red and black wire. Later I removed it and soldered at the back side for a better look of the board.

Add TipAsk QuestionCommentDownload

## Step 15: Solder the Components

Before soldering the components make holes at corners for mounting.

Solder all the components as per schematic.

Apply heat sink to two MOSFETs as well as power diode.

Note: The power diode MBR2045 have two anodes and one cathode. So short the two anodes.

I used thick wire for power lines and ground and thin wires for signal.signal. Thick wire is mandatory as the controller is designed for higher current.

Add TipAsk QuestionCommentDownload

## Step 16: Connect the Current Sensor

After connecting all the components solder two thick wire to the load MOSFET's drain and upper terminal of load side fuse holder. Then connect these wires to the screw terminal provided in the current sensor( ACS 712).

Add TipAsk QuestionCommentDownload

## Step 17: Make the Indication and Temperature Sensor Panel

I have shown two led in my schematic. But I added a third led(bi-color) for indicating the solar panel status in future.

Prepare small size perforated board as shown. Then make two holes (3.5mm) by drill on left and right( for mounting).

Insert the LEDs and solder it to the back side of the board.

Insert a 3 pins female header for the temperature sensor and then solder it.

Solder 10 pins right angle header for external connection.

Now connect the RGB led anode terminal to the temperature sensor Vcc(pin-1).

Solder the cathode terminals of two bi-color led.

Then join the solder points the LEDs terminal to the headers. You can paste a sticker with pin name for easy identifications.

Add TipAsk QuestionCommentDownload

## Step 18: Connections for Charge Controller

Connect the Charge Controller to the Battery first, because this allows the Charge Controller to get calibrated to whether it is the 6V or 12V system. Connect the negative terminal first and then positive. Connect the solar panel(negative first and then positive) At last connect the load.

The charge controller load terminal is suitable for only the DC load.

How to run an AC Load?

If you want to run AC appliances then you must need an inverter. Connect the inverter directly to the battery. See the above picture.

Add TipAsk QuestionCommentDownload

## Step 19: Final Testing :

After making the main board and indication board connect the header with jumper wires(female-female)

Refer to the schematic during this connection. Wrong connection may damage the circuits. So be care full in this stage.

Plug the USB cable to the Arduino and then upload the code. Remove the USB cable. If you want to see the serial monitor then keep it connected.

Fuse Rating: In demo, I have put a 5A fuse in the fuse holder. But in practical use, put a fuse with 120 to 125% of short circuit current.

Example :A 100W solar panel having Isc=6.32A needs a fuse 6.32x1.25 = 7.9 or 8A

How to test?

I used a buck-boost converter and black cloth to test the controller. The converter input terminals are connected to the battery and the output is connected to the charge controller battery terminal.

Battery status :

Rotate the converter potentiometer by a screwdriver to simulate different battery voltages. As the battery voltages change the corresponding led will turn off and turn on.

Note: During this process, Solar panel should be disconnected or covered with a black cloth or cardboard.

Dawn/Dusk: To simulate dawn and dusk using black cloth.

Night: Cover the solar panel entirely.

Day: Remove the cloth from the solar panel.

Transition: slow the remove or cover the cloth to adjust different solar panel voltages.

Load Control: According to the battery condition and dawn/dusk situation the load will turn on and off.

Temperature Compensation :

Hold the temperature sensor to increase the temperature and place any cold things like ice to decrease the temp. It will be immediately displayed on the LCD.

The compensated charge setpoint value can be seen on the serial monitor.

In the next step onward I will describe the making of enclosure for this charge controller.

Add TipAsk QuestionCommentDownload

## Step 20: Mounting the Main Board:

Place the main board inside the enclosure. Mark the hole position by a pencil.

Then apply hot glue to the marking position.

Place the plastic base over the glue.

Then place the board over the base and screw the nuts.

Add TipAsk QuestionCommentDownload

## Step 21: Make Space for LCD:

Mark the LCD size on the front cover of the enclosure.

Cut out the marked portion by using a Dremel or any other cutting tool. After cutting finish it by using a hobby knife.

Add TipAsk QuestionCommentDownload

## Step 22: Drill Holes:

Drill holes for mounting the LCD,Led indication panel,Reset button and external terminals

Add TipAsk QuestionCommentDownload

## Step 23: Mount Everything:

After making holes mount the panels, 6 pin screw terminal and reset button.

Add TipAsk QuestionCommentDownload

## Step 24: Connect the External 6 Pin Terminal :

For connecting the solar panel, battery and load an external 6pin screw terminal is used.

Connect the external terminal to the corresponding terminal of the main board.

Add TipAsk QuestionCommentDownload

## Step 25: Connect the LCD, Indicator Panel and Reset Button :

Connect the indicator panel and LCD to the main board as per the schematic. (Use female-female jumper wires)

One terminal of the reset button goes to RST of Arduino and other goes to GND.

After all connections. Close the front cover and screw it.

Add TipAsk QuestionCommentDownload

## Step 26: Ideas and Planning

How to plot real-time graphs?

It is very interesting if you can plot the serial monitor parameters (like battery and solar voltages) on a graph on your laptop screen. It can be done very easily if you know a little bit on Processing.

To know more you can refer to Arduino and Processing ( Graph Example ). (http://arduining.com/2013/08/05/arduino-and-processing-graph-example/)

How to save that data?

This can be done easily by using SD card but this includes more complexity and cost. To solve this I searched through the internet and found an easy solution. You can save data in Excel sheets.

For details, you can refer seeing-sensors-how-to-visualize-and-save-arduino-sensed-data (http://www.dustynrobots.com/news/seeing-sensors-how-to-visualize-and-save-arduino-sensed-data/)

The above pictures downloaded from the web. I attached to understand what I want to do and what you can do.

Future Planning :

1. Remote data logging via Ethernet or WiFi.

2. More powerful charging algorithm and load control

3.Adding a USB charging point for smartphone/tablets

Hope you enjoy my Instructables.

Please suggest any improvements. Raise comments if any mistakes or errors.

Follow me for more updates and new interesting projects.

Thanks :)

Add TipAsk QuestionCommentDownload

Tech Contest

Runner Up in the
Tech Contest

View Contest

Microcontroller Contest

Runner Up in the
Microcontroller Contest

View Contest

Formlabs Contest

Participated in the
Formlabs Contest

View Contest

## 16 People Made This Project!

- ARDUINO SOLAR CHARGE CONTROLLER ( Version 2.0)
  SRKH made it!
- ARDUINO SOLAR CHARGE CONTROLLER ( Version 2.0)
  kiatl1 made it!
- ARDUINO SOLAR CHARGE CONTROLLER ( Version 2.0)
  miroslavnedev67 made it!
- ARDUINO SOLAR CHARGE CONTROLLER ( Version 2.0)
  KoyyalaP made it!
- ARDUINO SOLAR CHARGE CONTROLLER ( Version 2.0)
  RimvydasP made it!
- ARDUINO SOLAR CHARGE CONTROLLER ( Version 2.0)
  Nikhil ChakravarthyC made it!
- ARDUINO SOLAR CHARGE CONTROLLER ( Version 2.0)
  Electronicslovers made it!
- ARDUINO SOLAR CHARGE CONTROLLER ( Version 2.0)
  zecos made it!
- ARDUINO SOLAR CHARGE CONTROLLER ( Version 2.0)
  DevikaM3 made it!
- See 7 More

Did you make this project? Share it with us!

I Made It!

## Recommendations

LED-Matrix With Web Server

LED-Matrix With Web Server by Brocki in LEDs

113 4.0K

1kW Arduino MPPT Solar Charge Controller (ESP32 + WiFi)

1kW Arduino MPPT Solar Charge Controller (ESP32 + WiFi) by ASCAS in Arduino

599 46K

DIY Fiber Optic Light Sculpture

DIY Fiber Optic Light Sculpture by andrei.erdei in LEDs

1 103 8.2K

Portable LED Lamp

Portable LED Lamp by mattwach in LEDs

20 2.8K

### Halloween Contest

- Halloween Contest

### Fashion Challenge

- Fashion Challenge

### 3D Printed Student Design Challenge

- 3D Printed Student Design Challenge

## 825 Comments

0

The keyn

The keyn

2 years ago

ReplyUpvote

hello,I connected the I2c module this way.but the screen is not coming.need to make changes to the code.Is there an error in my connections.help me !

arduino devre arıza.png (https://content.instructables.com/ORIG/FB3/C9NG/JTOMZKB2/FB3C9NGJTOMZKB2.png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)

3 replies

0

kjshinde19

kjshinde19The keyn

Reply 5 months ago

ReplyUpvote

hi,
did you get your simulation working ?
if yes , then can you please send me the proteus file at this
email:- kjshinde19@gmail.com,
thank you in advance.

0

InsafZ

InsafZThe keyn

Reply 2 years ago

ReplyUpvote

hello sir can you send to me your file schématic my mail is insafzaidi346@gmail.com and thanks alot

0

QasimI3

QasimI3The keyn

Reply 2 years ago

ReplyUpvote

The direction of irf9540 is not right. change the direction according to data sheet

0

amelchahmi

amelchahmi

Question 6 months ago

AnswerUpvote

Hello, can i use this for a 9v system. If not, what all are the modifications required in the design ?

0

sharanvshnu

sharanvshnu

8 months ago

ReplyUpvote

hey.... Im using the Same IRF9540 and 2n2222a for charging purpose but i dont get its max current on 100% duty cycle.Can you guys help me out?

0

atomic79greg

atomic79greg

Question 11 months ago

AnswerUpvote

do I need a full-blown arduino for this or can I get away with a blue/black-pill STM32 ?
(don't really need the lcd display...also considering being much more old-school/analog:
http://mdpub.com/555Controller/index.html)

0

Roanne13

Roanne13

Question 1 year ago

AnswerUpvote

Sir i would like to ask what app did you use to simulate this?
thank you very much

0

jishnuzeus

jishnuzeus

1 year ago

ReplyUpvote

Can i use this for a 24v system. If not, what all are the modifications required in the design?

1 reply

0

pisti870424

pisti870424jishnuzeus

Reply 1 year ago

ReplyUpvote

Igen de az ellenálásokat érdemes cserélni. Nekem 10k ohm és 1k ohm ellenálások vannak benne. Viszont a fentebb leírt ellenálás értékeket is módosítani kell

R1= 10000;
R2 = 1000;

ertek = analogRead(A0);
vki =(ertek * 5.00) / 1023.00;
voltage = vki / (R2/(R1+R2));

And 24 volt okay

0

janipani

janipani

1 year ago

ReplyUpvote

plz help me anyone how to connect the LCD it is not working plz guyz

 (https://content.instructables.com/ORIG/FFX/J5XH/K7VY2SIY/FFXJ5XHK7VY2SIY.png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)

2 replies

0

pisti870424

pisti870424janipani

Reply 1 year ago

ReplyUpvote

Szia. Dobj egy mailt. Segítek a kijelző telepítésében.

0

opengreenenergy

opengreenenergyjanipani

Reply 1 year ago

ReplyUpvote

The connection will be as follow:
LCD-> Arduino
VCC-> VCC
GND-> GND
SDA-> A4
SCL-> A5

0

merocle

merocle

1 year ago on Step 26

ReplyUpvote

that's great project, thanks for sharing!
just one thing that I want to add is mqtt client for monitoring )

0

opengreenenergy

opengreenenergy

1 year ago

ReplyUpvote

Hi guys,
I have published anew Instructctables which is an upgraded version of this project.
You can find in the below link:
https://www.instructables.com/id/ARDUINO-PWM-SOLAR-CHARGE-CONTROLLER-V-202/

 (https://content.instructables.com/ORIG/FMU/Q3WZ/K84NJT6F/FMUQ3WZK84NJT6F.jpg?auto=webp&fit=bounds&frame=1)

0

fonetainer

fonetainer

3 years ago

ReplyUpvote

aim getting following error while uploading the code to Arduino nano

Arduino: 1.8.5 (Mac OS X), Board: "Arduino Nano, ATmega328P"

V2_Deba_168:91: error: 'POSITIVE' was not declared in this scope

LiquidCrystal_I2C lcd(0x27, 2, 1, 0, 4, 5, 6, 7, 3, POSITIVE); // Set the LCD I2C address // In my case 0x27

^

/Users/paaker/Documents/Arduino/V2_Deba_168/V2_Deba_168.ino: In function 'void setup()':

V2_Deba_168:106: error: no matching function for call to 'LiquidCrystal_I2C::begin(int, int)'

lcd.begin(20, 4); // initialize the lcd for 16 chars 2 lines, turn on backlight

^

/Users/paaker/Documents/Arduino/V2_Deba_168/V2_Deba_168.ino:106:18: note: candidate is:

In file included from /Users/paaker/Documents/Arduino/V2_Deba_168/V2_Deba_168.ino:8:0:

/Users/paaker/Documents/Arduino/libraries/Arduino-LiquidCrystal-I2C-library-master/LiquidCrystal_I2C.h:76:7: note: void LiquidCrystal_I2C::begin()

void begin();

^

/Users/paaker/Documents/Arduino/libraries/Arduino-LiquidCrystal-I2C-library-master/LiquidCrystal_I2C.h:76:7: note: candidate expects 0 arguments, 2 provided

exit status 1

'POSITIVE' was not declared in this scope

avrdude: stk500_recv(): programmer is not responding

avrdude: stk500_getsync() attempt 7 of 10: not in sync: resp=0x00

avrdude: stk500_recv(): programmer is not responding

avrdude: stk500_getsync() attempt 8 of 10: not in sync: resp=0x00

avrdude: stk500_recv(): programmer is not responding

avrdude: stk500_getsync() attempt 9 of 10: not in sync: resp=0x00

avrdude: stk500_recv(): programmer is not responding

avrdude: stk500_getsync() attempt 10 of 10: not in sync: resp=0x00

Problem uploading to board. See http://www.arduino.cc/en/Guide/Troubleshooting#upload for suggestions.

Invalid library found in /Users/paaker/Documents/Arduino/libraries/LiquidCrystal_I2C: /Users/paaker/Documents/Arduino/libraries/LiquidCrystal_I2C

Invalid library found in /Users/paaker/Documents/Arduino/libraries/LiquidCrystal_I2C: /Users/paaker/Documents/Arduino/libraries/LiquidCrystal_I2C

This report would have more information with

"Show verbose output during compilation"

option enabled in File -> Preferences.

4 replies

0

tgray1

tgray1fonetainer

Reply 2 years ago

ReplyUpvote

I also had a lot of trouble with the LCD using the original code. I removed all of Dutta's libraries but two:
'#include <Wire.h>
#include <LiquidCrystal_I2C.h>
I edited the I2C address as
LiquidCrystal_I2C lcd(0x27, 20, 4); // Set the LCD I2C address for 20 characters and 4 lines
I added the init command at the top of the lcd section in Setup:
lcd.init(); //turn on the display
These changes fixed all my lcd display issues.

0

janipani

janipanitgray1

Reply 1 year ago

ReplyUpvote

how to connect the lcd to arduino or which pin should be added

 (https://content.instructables.com/ORIG/FKB/7DWX/K7VY2S37/FKB7DWXK7VY2S37.png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)

0

f1l1pp0sk0palas

f1l1pp0sk0palastgray1

Reply 2 years ago

ReplyUpvote

tgray1 (https://www.instructables.com/member/tgray1/) THANK YOU!!!!!!!!!!! YOUR COMMENT HELPED ME A LOT.

0

farmerkeith

farmerkeithfonetainer

Reply 3 years ago

ReplyUpvote

Hi fonetainer, You seem to have a lot of problems with this software upload.

Are you able to upload a simple sketch to your Arduino? eg the Blink example in the standard distribution.

Once that is OK, you need to check what library (if any) you have for the LCD. It should be LiquidCrystal_I2C.h although there are several different versions of this library and some work better than others. You may need to change versions if it will not work with the one you have. However first just getting the loading correct and post your new error messages would be a good step.

Keith

More CommentsPost Comment

Categories

- Circuits
- Workshop
- Craft
- Cooking
- Living
- Outside
- Teachers

About Us

- Who We Are
- Why Publish?

Resources

- Sitemap
- Help
- Contact

Find Us

- (https://www.instagram.com/instructables/)
- (https://www.pinterest.com/instructables)
- (https://www.facebook.com/instructables)
- (https://www.twitter.com/instructables)

© 2021 Autodesk, Inc.

- Terms of Service (http://usa.autodesk.com/adsk/servlet/item?siteID=123112&id=21959721)|
- Privacy Statement (http://usa.autodesk.com/adsk/servlet/item?siteID=123112&id=21292079)|
- Privacy settings|
- Legal Notices & Trademarks (http://usa.autodesk.com/legal-notices-trademarks/)

Autodesk (http://www.autodesk.com)
