dkprasad-surati/MPPT-SOLAR-CHARGE-INVERTER/v2.2/Schematic_Arduino+Solar+Charge+Controller+V2.0_Sheet_1_20200320104815.pdf

# +5VA³

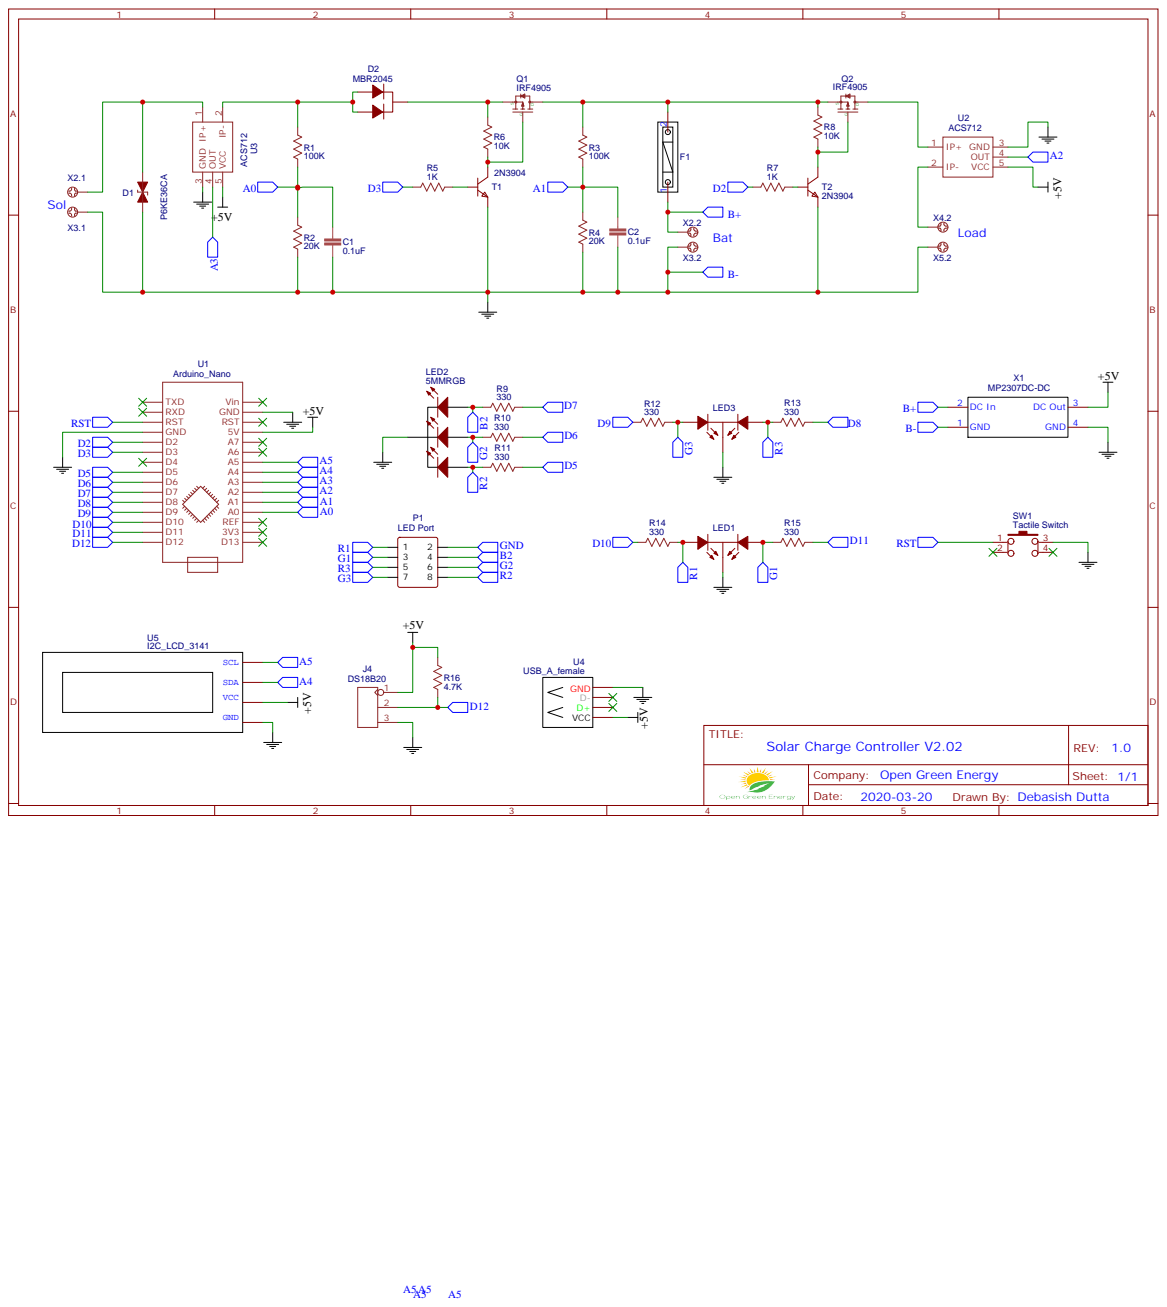
[picture p17: page 1]

Company: Open Green Energy

Drawn By: Debasish Dutta
