dkprasad-surati/MPPT-SOLAR-CHARGE-INVERTER/v2/F2SBFVUI8SLPCIY.pdf

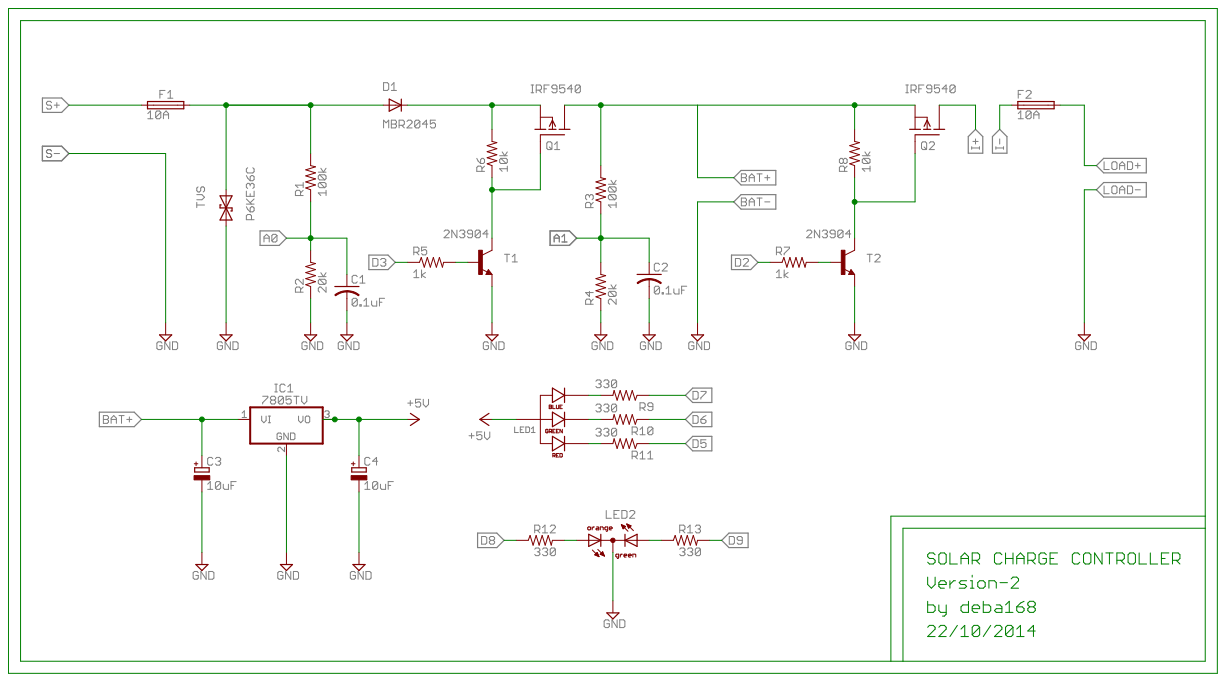
[picture p18: page 1]
